PulseRain/M10_PCB/README.md

# M10_PCB
PCB Design File for PulseRain M10 board
