PulseRain/M10_PCB/V1.11/schematic.pdf

A

A

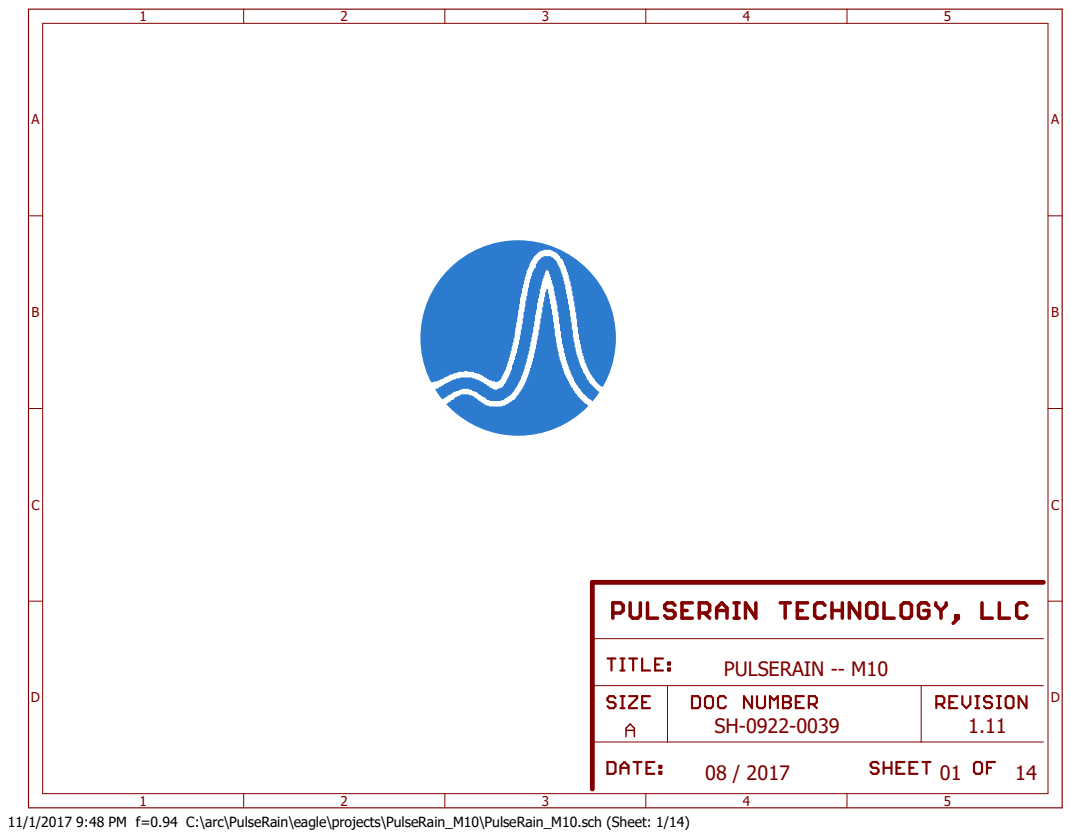
[picture p15: page 1]
PULSERAIN -- M10

11/1/2017 9:48 PM f=0.94 C:\arc\PulseRain\eagle\projects\PulseRain_M10\PulseRain_M10.sch (Sheet: 1/14)

# GND ⁺³V3 10k 10k

# C5 R⁷ R⁸

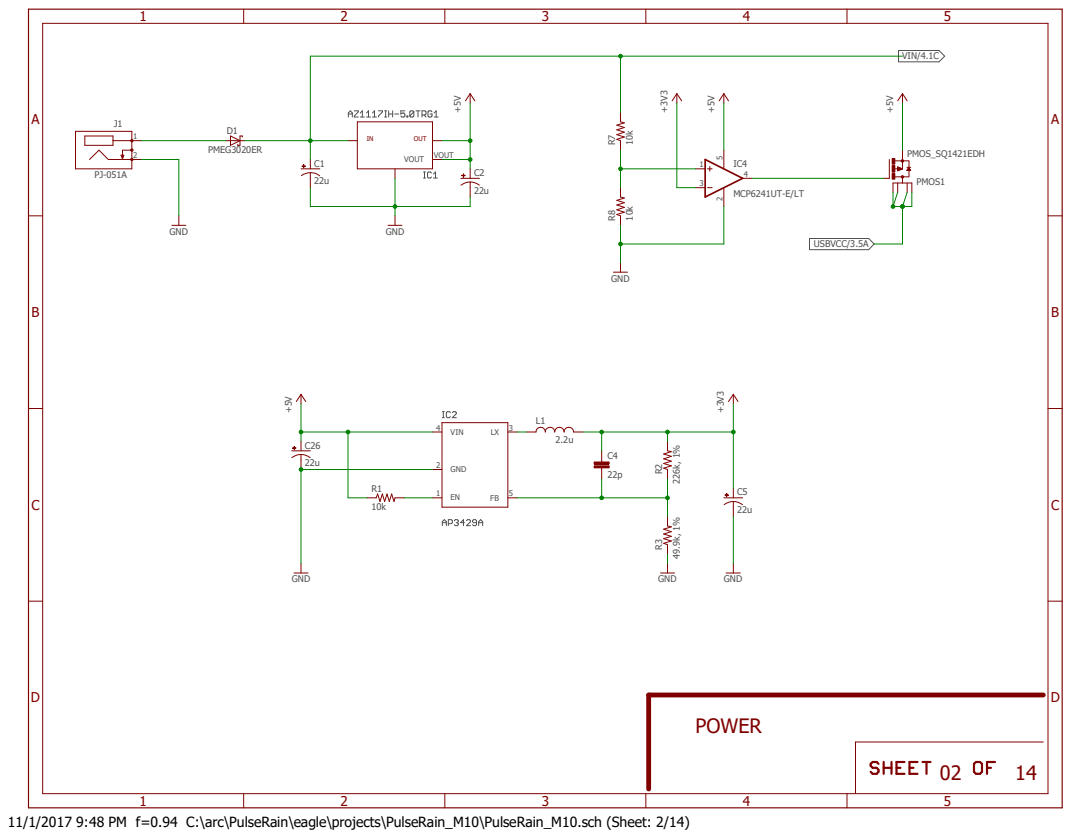
[picture p16: page 2]

11/1/2017 9:48 PM f=0.94 C:\arc\PulseRain\eagle\projects\PulseRain_M10\PulseRain_M10.sch (Sheet: 2/14)

A

A

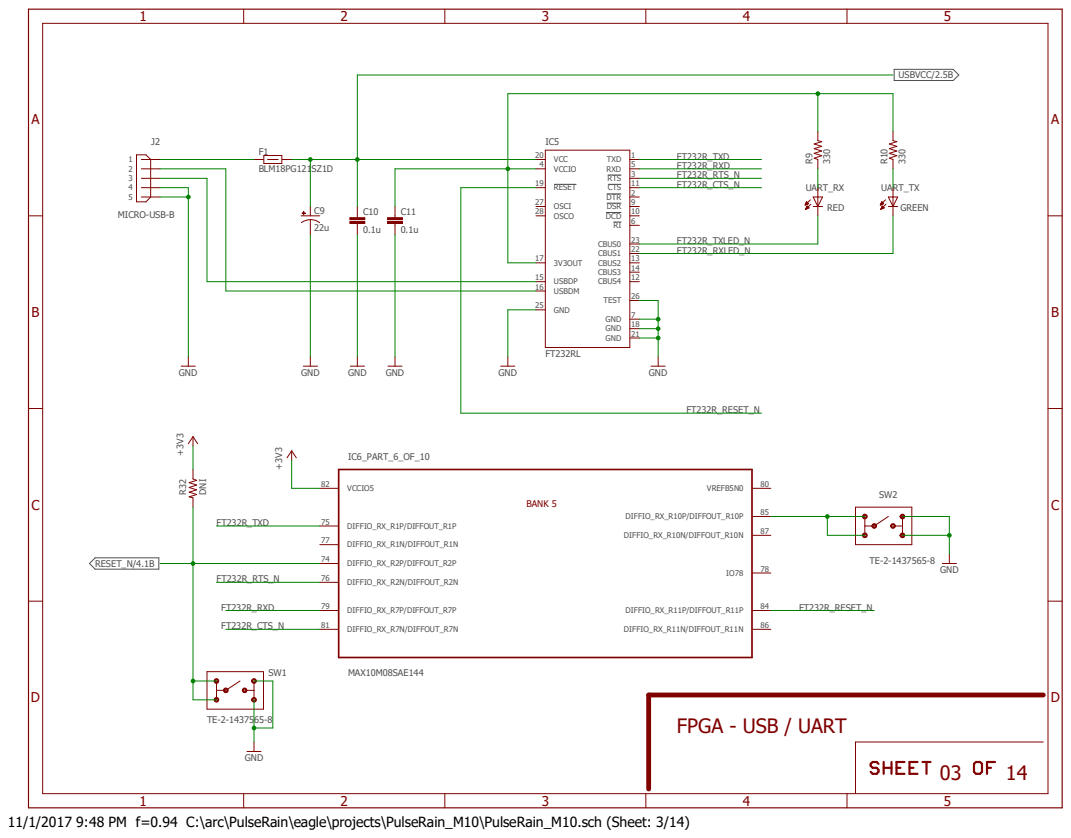
[picture p17: page 3]
MICRO-USB-B; GND; BLM18PG121SZ1D; RED; GREEN ³³⁰; MAX10M08SAE144 ⁺³V3; GND DNI +³V3; IC5VCC 20; 3V3OUT 17; USBDP 15; USBDM 16; OSCO 28; OSCI 27; TXD; 1 RXD; 5 RTS; 3 CTS; 11 DTR; 2 DSR; 9 DCD; 6 CBUS0; 23 CBUS1; 22 CBUS2; 13 CBUS3; 14 CBUS4; 12 VCCIO 4; RESET 19; GND 25; 18 TEST; 26 GND; UART_RX; UART_TX R⁹; R¹⁰; DIFFIO_RX_R1P/DIFFOUT_R1P 75; DIFFIO_RX_R1N/DIFFOUT_R1N 77; DIFFIO_RX_R2P/DIFFOUT_R2P 74; DIFFIO_RX_R2N/DIFFOUT_R2N 76; DIFFIO_RX_R10P/DIFFOUT_R10P; 85 DIFFIO_RX_R10N/DIFFOUT_R10N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

FPGA - USB / UART

11/1/2017 9:48 PM f=0.94 C:\arc\PulseRain\eagle\projects\PulseRain_M10\PulseRain_M10.sch (Sheet: 3/14)

# 9~ 9 SDA SDA

# 8 SCL SCL

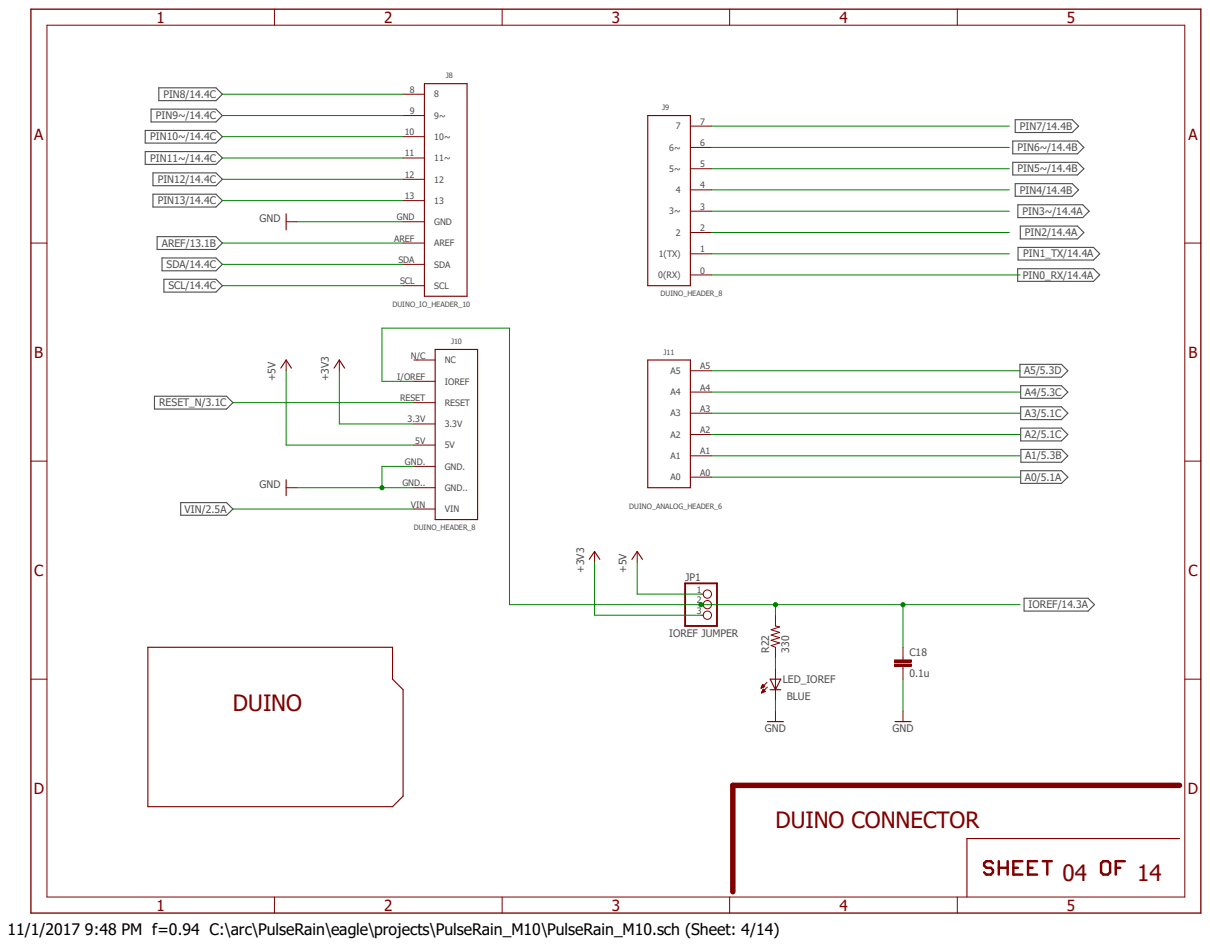
[picture p18: page 4]
IOREF JUMPER ⁺³V3; GND ³³⁰; BLUE; GND; DUINO_IO_HEADER_10; DUINO_HEADER_8 DUINO_HEADER_8 GND⁺⁵V; DUINO_ANALOG_HEADER_6; C18 R²²; LED_IOREF; AREF AREF; GND GND; IOREF I/OREF; RESET RESET; GND.. GND..; GND. GND.; VIN VIN; VIN/2.5A; IOREF/14.3A; RESET_N/3.1C; SCL/14.4C; SDA/14.4C; AREF/13.1B; PIN13/14.4C; PIN12/14.4C; PIN8/14.4C; PIN0_RX/14.4A; PIN1_TX/14.4A; PIN9~/14.4C; PIN10~/14.4C; PIN11~/14.4C; PIN7/14.4B; PIN6~/14.4B; PIN5~/14.4B; PIN4/14.4B; PIN3~/14.4A; PIN2/14.4A; DUINO CONNECTOR; DUINO

11/1/2017 9:48 PM f=0.94 C:\arc\PulseRain\eagle\projects\PulseRain_M10\PulseRain_M10.sch (Sheet: 4/14)

# 1 VSS 4

A

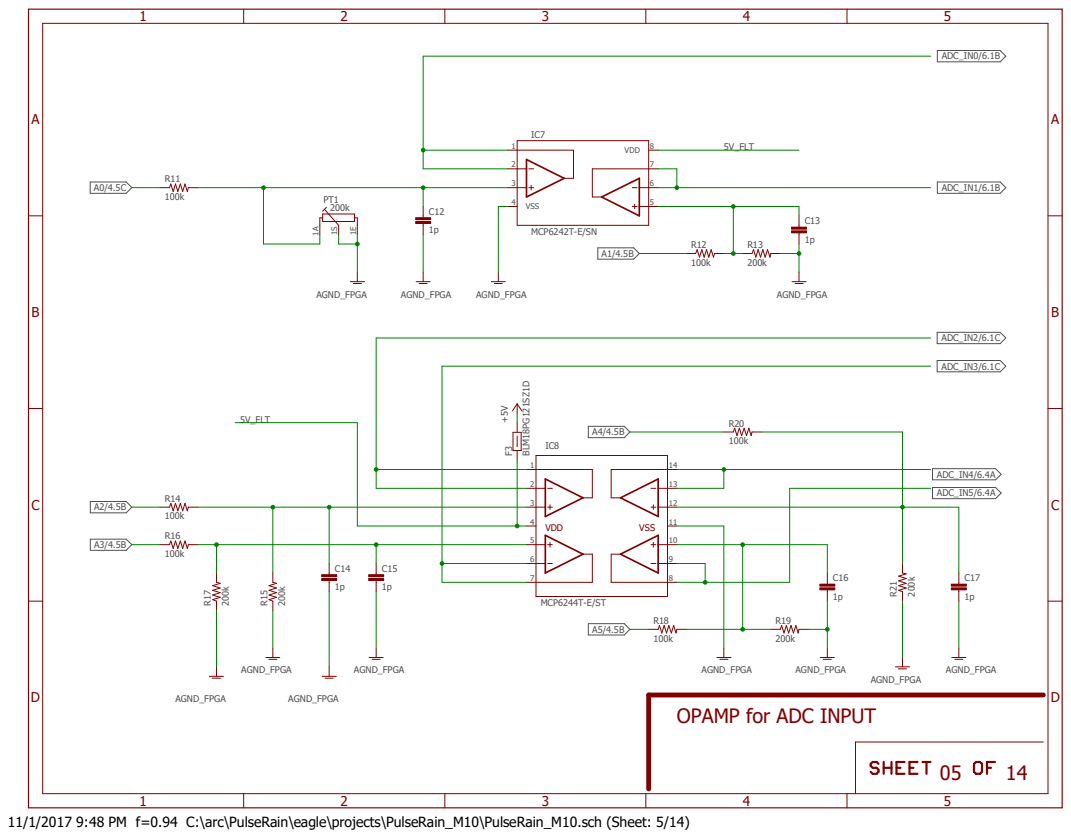
[picture p19: page 5]

OPAMP for ADC INPUT

11/1/2017 9:48 PM f=0.94 C:\arc\PulseRain\eagle\projects\PulseRain_M10\PulseRain_M10.sch (Sheet: 5/14)

A

A

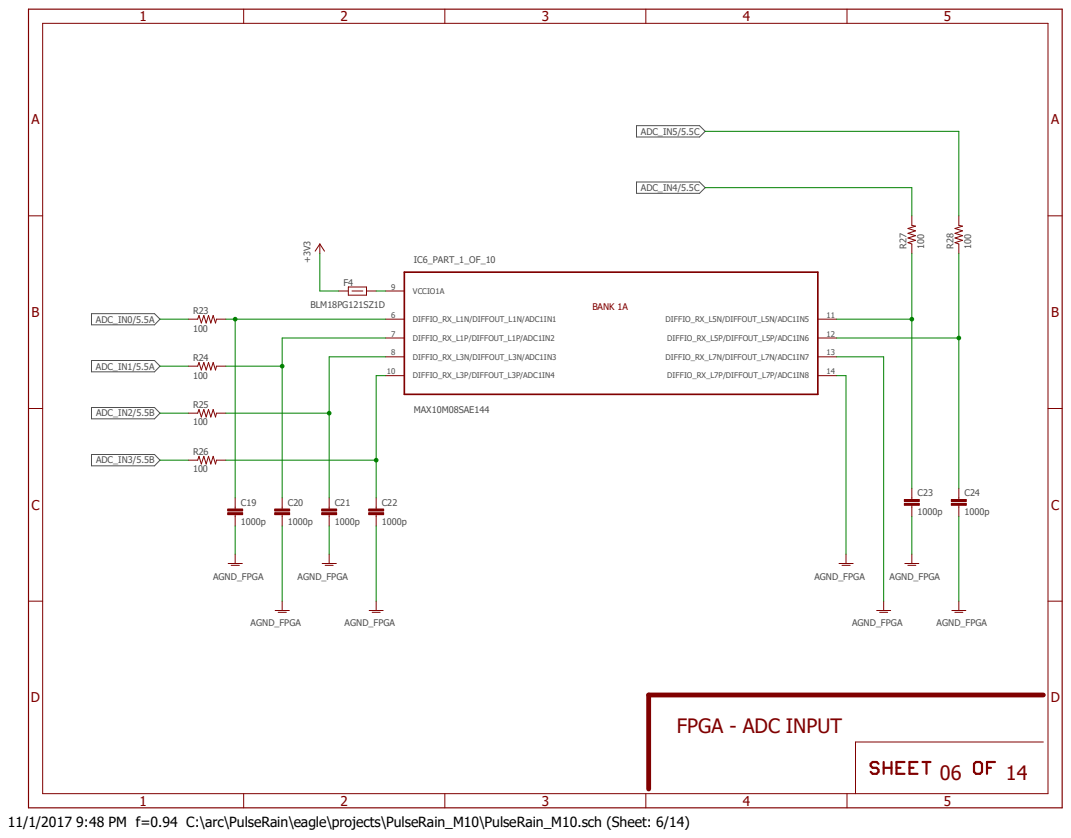
[picture p20: page 6]

11/1/2017 9:48 PM f=0.94 C:\arc\PulseRain\eagle\projects\PulseRain_M10\PulseRain_M10.sch (Sheet: 6/14)

A

A

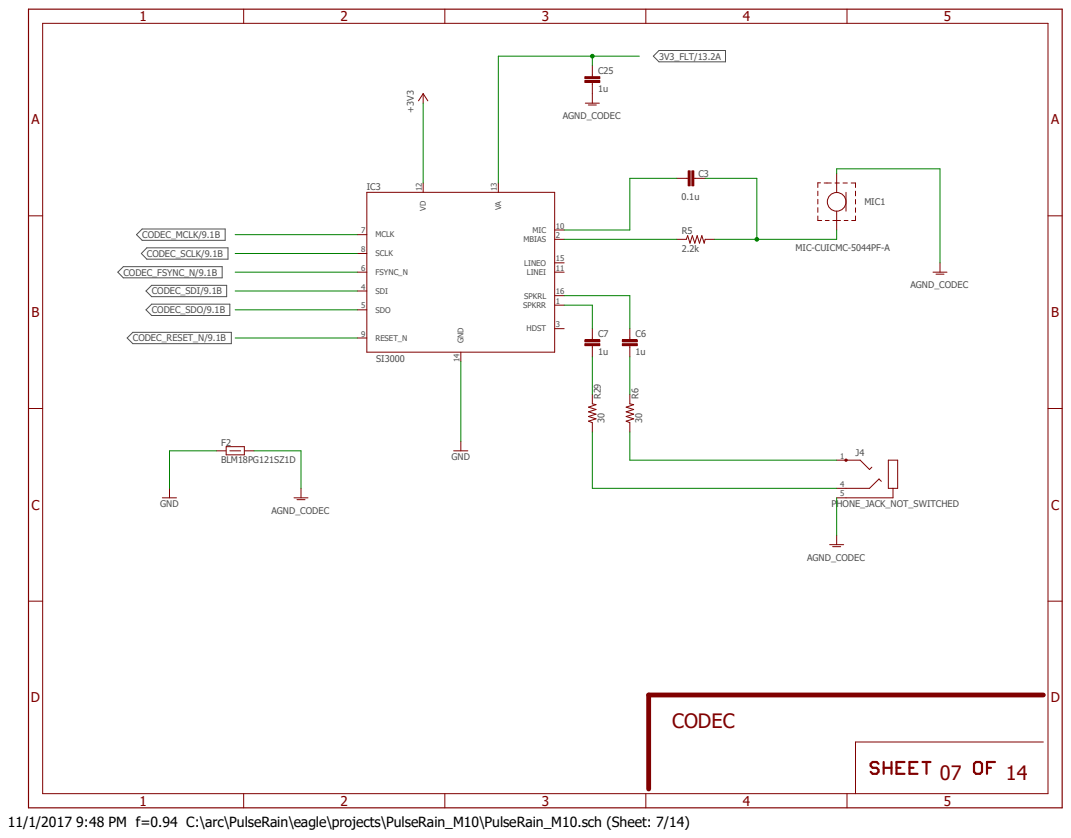
[picture p21: page 7]
PHONE_JACK_NOT_SWITCHED; GND; MIC-CUICMC-5044PF-A; AGND_CODEC; BLM18PG121SZ1D; R5 R²⁹; R⁶ MBIAS; 2 HDST; 3 SPKRR; 1 SDI 4; VA ¹³ GND 14; LINEO; 15 SPKRL; 16 SDO 5; FSYNC_N 6; MCLK 7; SCLK 8; LINEI; 11 MIC; 10 RESET_N 9; MIC1; 3V3_FLT/13.2A; CODEC_MCLK/9.1B; CODEC_SCLK/9.1B; CODEC_FSYNC_N/9.1B; CODEC_SDI/9.1B; CODEC_SDO/9.1B; CODEC_RESET_N/9.1B; CODEC

11/1/2017 9:48 PM f=0.94 C:\arc\PulseRain\eagle\projects\PulseRain_M10\PulseRain_M10.sch (Sheet: 7/14)

11/1/2017 9:48 PM f=0.94 C:\arc\PulseRain\eagle\projects\PulseRain_M10\PulseRain_M10.sch (Sheet: 8/14)

MAX10M08SAE144

# MAX10M08SAE144 ⁺³V3 +³V3

SRAM

GND | +³V3

12MHz

GND ⁺³V3

IC6_PART_7_OF_10

CLK2P/DIFFIO_RX_R14P/DIFFOUT_R14P 88 | CLK2N/DIFFIO_RX_R14N/DIFFOUT_R14N 89 | CLK3P/DIFFIO_RX_R16P/DIFFOUT_R16P 90 | CLK3N/DIFFIO_RX_R16N/DIFFOUT_R16N 91 | VCCIO6_1 94 | VREFB6N0 | 97 VCCIO6_2 103 | DIFFIO_RX_R18N/DIFFOUT_R18N 93 | DPCLK2/DIFFIO_RX_R26N/DIFFOUT_R26N 98 | DPCLK3/DIFFIO_RX_R26P/DIFFOUT_R26P 96 | DIFFIO_RX_R18P/DIFFOUT_R18P 92 | DIFFIO_RX_R27P/DIFFOUT_R27P | 99 DIFFIO_RX_R27N/DIFFOUT_R27N | 101 DIFFIO_RX_R28P/DIFFOUT_R28P | 100 DIFFIO_RX_R28N/DIFFOUT_R28N | 102 DIFFIO_RX_R33P/DIFFOUT_R33P | 105 DIFFIO_RX_R33N/DIFFOUT_R33N | 106

IC6_PART_3_OF_10

CLK0N/DIFFIO_RX_L18N/DIFFOUT_L18N 26 | CLK0P/DIFFIO_RX_L18P/DIFFOUT_L18P 27 | CLK1N/DIFFIO_RX_L20N/DIFFOUT_L20N 28 | CLK1P/DIFFIO_RX_L20P/DIFFOUT_L20P 29 | PLL_L_CLKOUTN/DIFFIO_RX_L27N/DIFFOUT_L27N | 32 PLL_L_CLKOUTP/DIFFIO_RX_L27P/DIFFOUT_L27P | 33 VCCIO2 31 | VREFB2N0 | 30

IC10

SO/SIO1 2 | NC/SIO2 3 | CS_N 1 | VSS 4 | SI/SIO0 | 5 SCK | 6 HOLD_N/SIO3 | 7 VCC | 8
IC9VCC 8 | GND | 4 OUT | 5 EN 1

3V3_PIN11~/14.2C

3V3_SDA/14.2C

3V3_SCL/14.2C

3V3_PIN8/14.2C
3V3_PIN9~/14.2C
3V3_PIN10~/14.2C

3V3_PIN12/14.2C

3V3_PIN13/14.2C

SRAM_SIO2

SRAM_SIO2

SRAM_SIO1

SRAM_SIO1

SRAM_SIO3

SRAM_SIO3

SRAM_SCK

SRAM_SCK

SRAM_SIO0

SRAM_SIO0

SRAM_CS_N

SRAM_CS_N

# FPGA - CLK / SRAM / IO

08 14

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
BANK 6

BANK 2

11/1/2017 9:48 PM f=0.94 C:\arc\PulseRain\eagle\projects\PulseRain_M10\PulseRain_M10.sch (Sheet: 9/14)

# MAX10M08SAE144 ⁺³V3

IC6_PART_4_OF_10

DIFFIO_TX_RX_B1N/DIFFOUT_B1N 38 | DIFFIO_TX_RX_B1P/DIFFOUT_B1P 39 | DIFFIO_TX_RX_B3N/DIFFOUT_B3N 41 | DIFFIO_TX_RX_B3P/DIFFOUT_B3P 43 | DIFFIO_TX_RX_B9N/DIFFOUT_B9N | 50 DIFFIO_TX_RX_B9P/DIFFOUT_B9P | 52 VCCIO3_1 40 | VREFB3N0 | 48 VCCIO3_2 49 | DIFFIO_TX_RX_B5P/DIFFOUT_B5P 45 | DIFFIO_TX_RX_B7P/DIFFOUT_B7P 47 | DIFFIO_TX_RX_B7N/DIFFOUT_B7N 46 | DIFFIO_TX_RX_B5N/DIFFOUT_B5N 44
IO54 | 54 DIFFIO_TX_RX_B12N/DIFFOUT_B12N | 55 DIFFIO_TX_RX_B12P/DIFFOUT_B12P | 56 DIFFIO_TX_RX_B14N/DIFFOUT_B14N | 57 DIFFIO_TX_RX_B14P/DIFFOUT_B14P | 58 DIFFIO_TX_RX_B16N/DIFFOUT_B16N | 59 DIFFIO_TX_RX_B16P/DIFFOUT_B16P | 60

3V3_PIN7/14.2B

3V3_PIN6~/14.2B

3V3_PIN5~/14.2B

3V3_PIN4/14.2B

3V3_PIN3~/14.2A

3V3_PIN2/14.2A

3V3_PIN1_TX/14.2A

3V3_PIN0_RX/14.2A

CODEC_SDI/7.1B

CODEC_SDO/7.1B

CODEC_FSYNC_N/7.1B

CODEC_MCLK/7.1B

CODEC_SCLK/7.1B
CODEC_RESET_N/7.1B

JTAG_PIN6/10.5C

JTAG_PIN8/10.5C

JTAG_PIN7/10.5C

09 14

# FPGA - PUSH BUTTON / IO

BANK 3

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
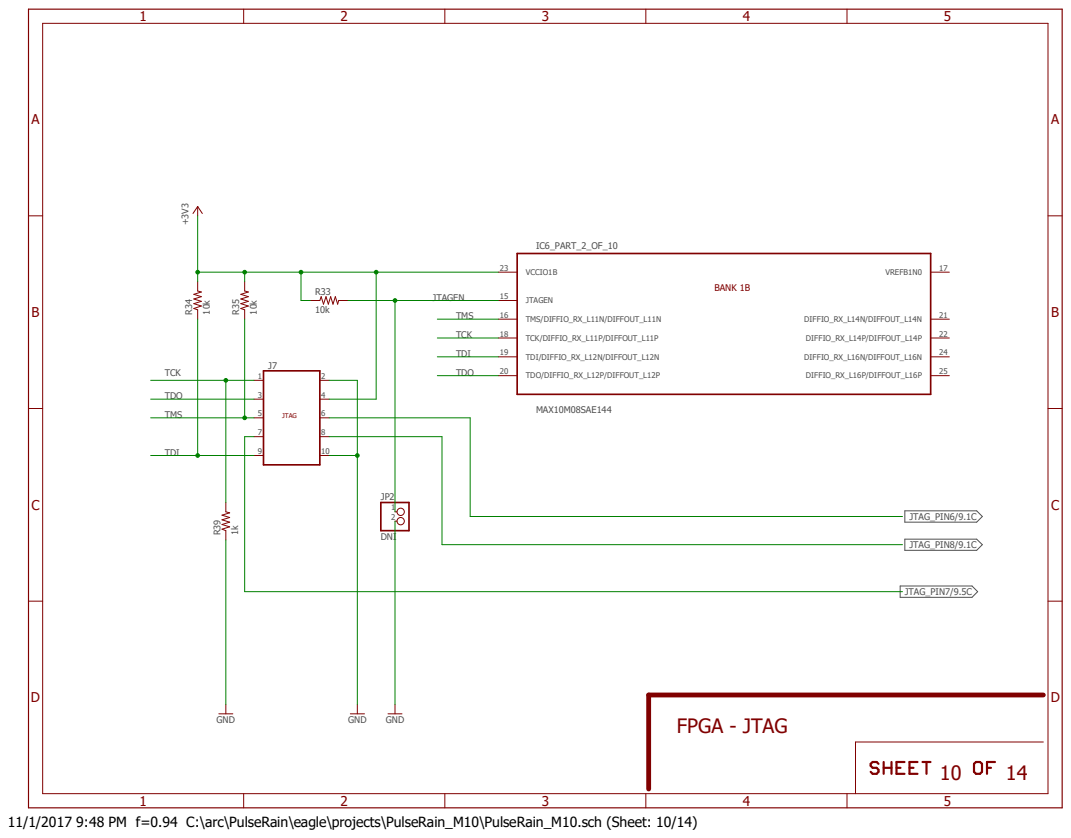
[picture p22: page 10]
MAX10M08SAE144 ⁺³V3; GND ¹⁰k; GND ¹k; DNI; GND; IC6_PART_2_OF_10; JTAGEN 15; TMS/DIFFIO_RX_L11N/DIFFOUT_L11N 16; TCK/DIFFIO_RX_L11P/DIFFOUT_L11P 18; TDI/DIFFIO_RX_L12N/DIFFOUT_L12N 19; TDO/DIFFIO_RX_L12P/DIFFOUT_L12P 20; DIFFIO_RX_L14N/DIFFOUT_L14N; 21 DIFFIO_RX_L14P/DIFFOUT_L14P; 22 DIFFIO_RX_L16N/DIFFOUT_L16N; 24 VCCIO1B 23; VREFB1N0; 17 DIFFIO_RX_L16P/DIFFOUT_L16P; R33 R³⁴; R³⁵ R³⁹; JTAGEN; TMS; TCK; TDI; TDO; JTAG_PIN6/9.1C; JTAG_PIN8/9.1C; JTAG_PIN7/9.5C; FPGA - JTAG; BANK 1B; JTAG

11/1/2017 9:48 PM f=0.94 C:\arc\PulseRain\eagle\projects\PulseRain_M10\PulseRain_M10.sch (Sheet: 10/14)

11/1/2017 9:48 PM f=0.94 C:\arc\PulseRain\eagle\projects\PulseRain_M10\PulseRain_M10.sch (Sheet: 11/14)

MAX10M08SAE144

# MAX10M08SAE144 ⁺³V3

GND ⁺³V3 +³V3

0472192001

IC6_PART_5_OF_10

IO62 62 | DIFFIO_TX_RX_B23N/DIFFOUT_B23N 64 | DIFFIO_TX_RX_B23P/DIFFOUT_B23P 65 | VCCIO4 67 | VREFB4N0 | 61
IO66 | 66 DIFFIO_TX_RX_B27N/DIFFOUT_B27N | 69 DIFFIO_TX_RX_B27P/DIFFOUT_B27P | 70

IC6_PART_8_OF_10

IO113 113 | DIFFIO_RX_T1P/DIFFOUT_T1P 110 | DIFFIO_RX_T1N/DIFFOUT_T1N 111 | VCCIO7 117 | VREFB7N0 | 112
IO114 | 114 DIFFIO_RX_T10P/DIFFOUT_T10P | 118 DIFFIO_RX_T10N/DIFFOUT_T10N | 119
IC11 DAT2 1 | CD/DAT3 2 | CMD 3 | VDD 4 | CLK | 5 VSS | 6 DAT0 | 7 DAT1 MICRO_SD_DAT2 | 8 MICRO_SD_DAT2

MICRO_SD_CD_DAT3

MICRO_SD_CD_DAT3

MICRO_SD_CMD

MICRO_SD_CMD

MICRO_SD_DAT1

MICRO_SD_DAT1

MICRO_SD_DAT0

MICRO_SD_DAT0

MICRO_SD_CLK

MICRO_SD_CLK

11 14

# FPGA - MICRO SD

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
BANK 4

BANK 7

A

A

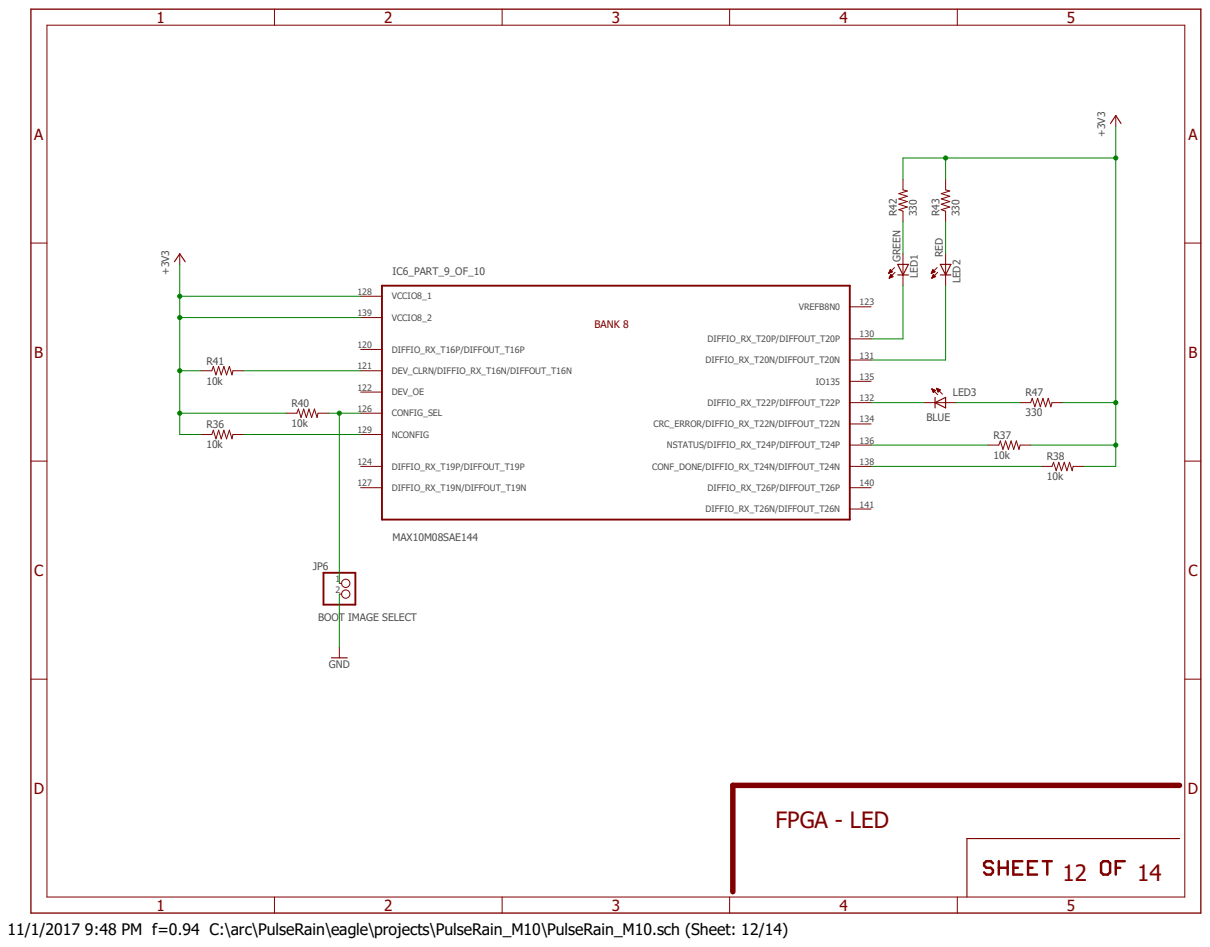
[picture p23: page 12]

11/1/2017 9:48 PM f=0.94 C:\arc\PulseRain\eagle\projects\PulseRain_M10\PulseRain_M10.sch (Sheet: 12/14)

# GND ⁺³V3

A

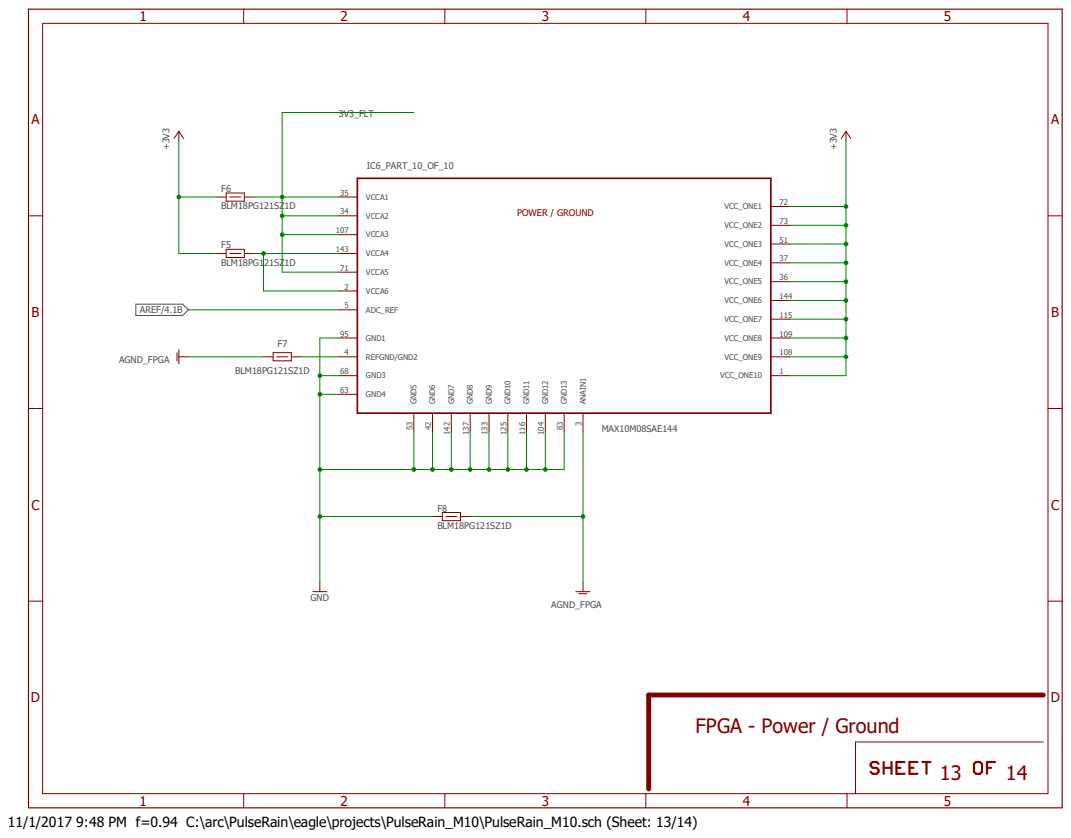
[picture p24: page 13]
MAX10M08SAE144; BLM18PG121SZ1D; AGND_FPGA; IC6_PART_10_OF_10 VCCA1 35; VCCA2 34; VCCA3 107; VCCA4 143; VCCA5 71; VCCA6 2; ADC_REF 5; VCC_ONE1; 72 VCC_ONE2; 73 VCC_ONE3; 51 VCC_ONE4; 37 VCC_ONE5; 36 VCC_ONE6; 144 VCC_ONE7; 115 VCC_ONE8; 109 VCC_ONE9; 108 VCC_ONE10; 1 GND1 95; REFGND/GND2 4; GND3 68; GND4 63; GND⁵ 53; GND⁶ 42; GND⁷ 142; GND⁸ 137; GND⁹ 133; GND¹⁰ 125; GND¹¹ 116; GND¹² 104; GND¹³ 83; ANAIN¹; AREF/4.1B; 3V3_FLT; POWER / GROUND

FPGA - Power / Ground

11/1/2017 9:48 PM f=0.94 C:\arc\PulseRain\eagle\projects\PulseRain_M10\PulseRain_M10.sch (Sheet: 13/14)

# TXS0108EPWR ⁺³V3

A

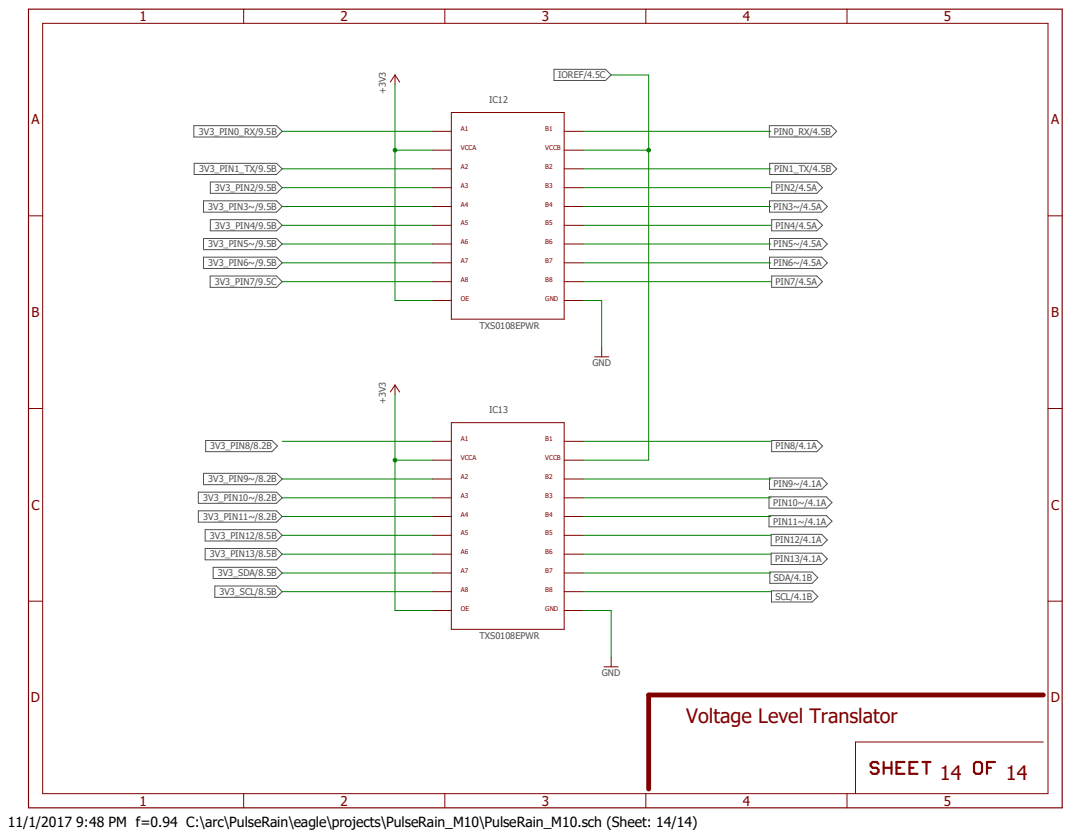
[picture p25: page 14]
TXS0108EPWR; GND; GND ⁺³V3; 3V3_PIN0_RX/9.5B; 3V3_PIN1_TX/9.5B; 3V3_PIN2/9.5B; 3V3_PIN3~/9.5B; 3V3_PIN4/9.5B; 3V3_PIN5~/9.5B; 3V3_PIN6~/9.5B; 3V3_PIN7/9.5C; PIN0_RX/4.5B; PIN1_TX/4.5B; PIN2/4.5A; PIN3~/4.5A; PIN4/4.5A; PIN5~/4.5A; PIN6~/4.5A; PIN7/4.5A; IOREF/4.5C; PIN8/4.1A; PIN9~/4.1A; PIN10~/4.1A; PIN11~/4.1A; PIN12/4.1A; PIN13/4.1A; SDA/4.1B; SCL/4.1B; 3V3_PIN9~/8.2B; 3V3_PIN10~/8.2B; 3V3_PIN12/8.5B; 3V3_PIN13/8.5B; 3V3_PIN8/8.2B; 3V3_PIN11~/8.2B; 3V3_SDA/8.5B; 3V3_SCL/8.5B; 5 A1VCCA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

Voltage Level Translator

11/1/2017 9:48 PM f=0.94 C:\arc\PulseRain\eagle\projects\PulseRain_M10\PulseRain_M10.sch (Sheet: 14/14)
