PulseRain/M10_PCB/V1.11/PulseRain_M10.brd

## EAGLE design V1.11/PulseRain_M10.brd (2017-11-02)

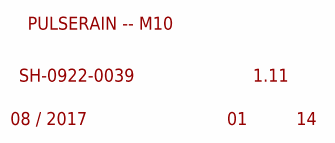
[picture p37: schematic PulseRain_M10.sch, sheet 1]

Parts:
GND: PULSERAIN_LOGO_BIGGER

Notes on the sheet:
1.11
SH-0922-0039
PULSERAIN -- M10
08 / 2017

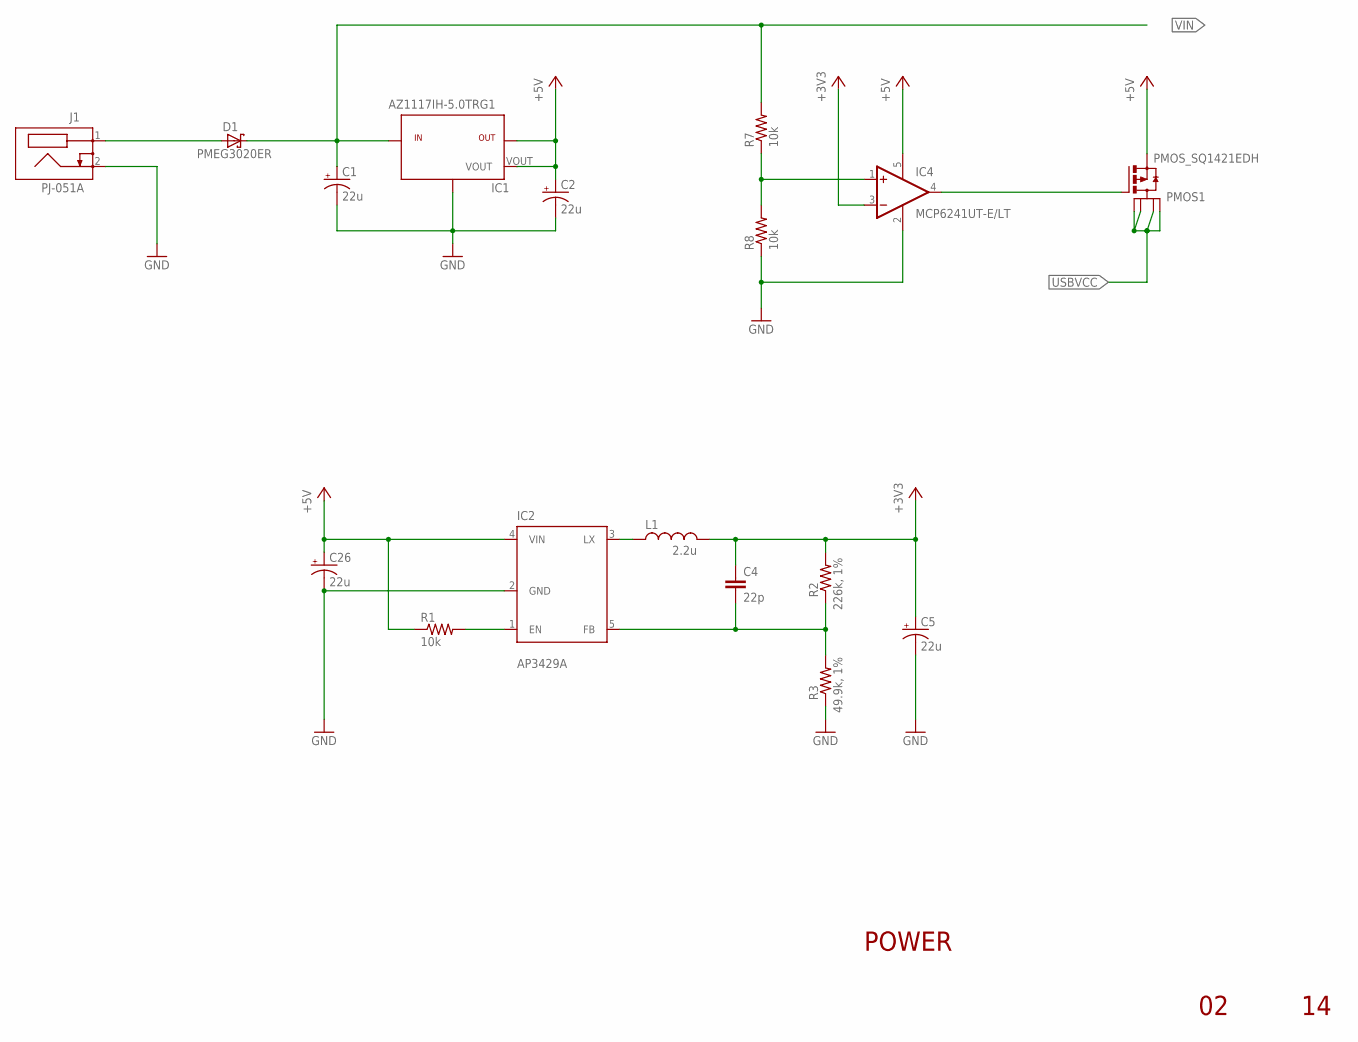
[picture p38: schematic PulseRain_M10.sch, sheet 2]

Parts:
C1, C2, C5, C26: 22u; PANASONIC_B
C4: 22p; 0603-CAP
D1: PMEG3020ER; SOD123W
IC1: AZ1117IH-5.0TRG1; SOT223
IC2: AP3429A; TSOT25
IC4: MCP6241UT-E/LT; SC-70-5
J1: PJ-051A
L1: 2.2u; DFE252012C
PMOS1: PMOS_SQ1421EDH; SC70-6L
R1, R7, R8: 10k; VISHAY-R-0603
R2: 226k, 1%; VISHAY-R-0603
R3: 49.9k, 1%; VISHAY-R-0603

Connections:
+3V3: C4.1, C5.+, IC4.3 (-IN), L1.2, R2.P$2 (2); also elsewhere on the board
+5V: C2.+, C26.+, IC1.2, IC1.VOUT, IC2.4 (VIN), IC4.5 (V+), PMOS1.4 (S), R1.P$1 (1); also elsewhere on the board
GND: C1.-, C2.-, C5.-, C26.-, IC1.1, IC2.2 (GND), IC4.2 (V-), J1.2, R3.P$1 (1), R8.P$1 (1); also elsewhere on the board
unnamed: D1.2, J1.1
unnamed: IC4.1 (+IN), R7.P$1 (1), R8.P$2 (2)
unnamed: IC2.3 (LX), L1.1
unnamed: IC2.1 (EN), R1.P$2 (2)
unnamed: C4.2, IC2.5 (FB), R2.P$1 (1), R3.P$2 (2)
unnamed: IC4.4 (OUT), PMOS1.3 (G)
USBVCC: PMOS1.1 (D1), PMOS1.2 (D2), PMOS1.5 (D3), PMOS1.6 (D4); also elsewhere on the board
VIN: C1.+, D1.1, IC1.3, R7.P$2 (2); also elsewhere on the board

Notes on the sheet:
POWER

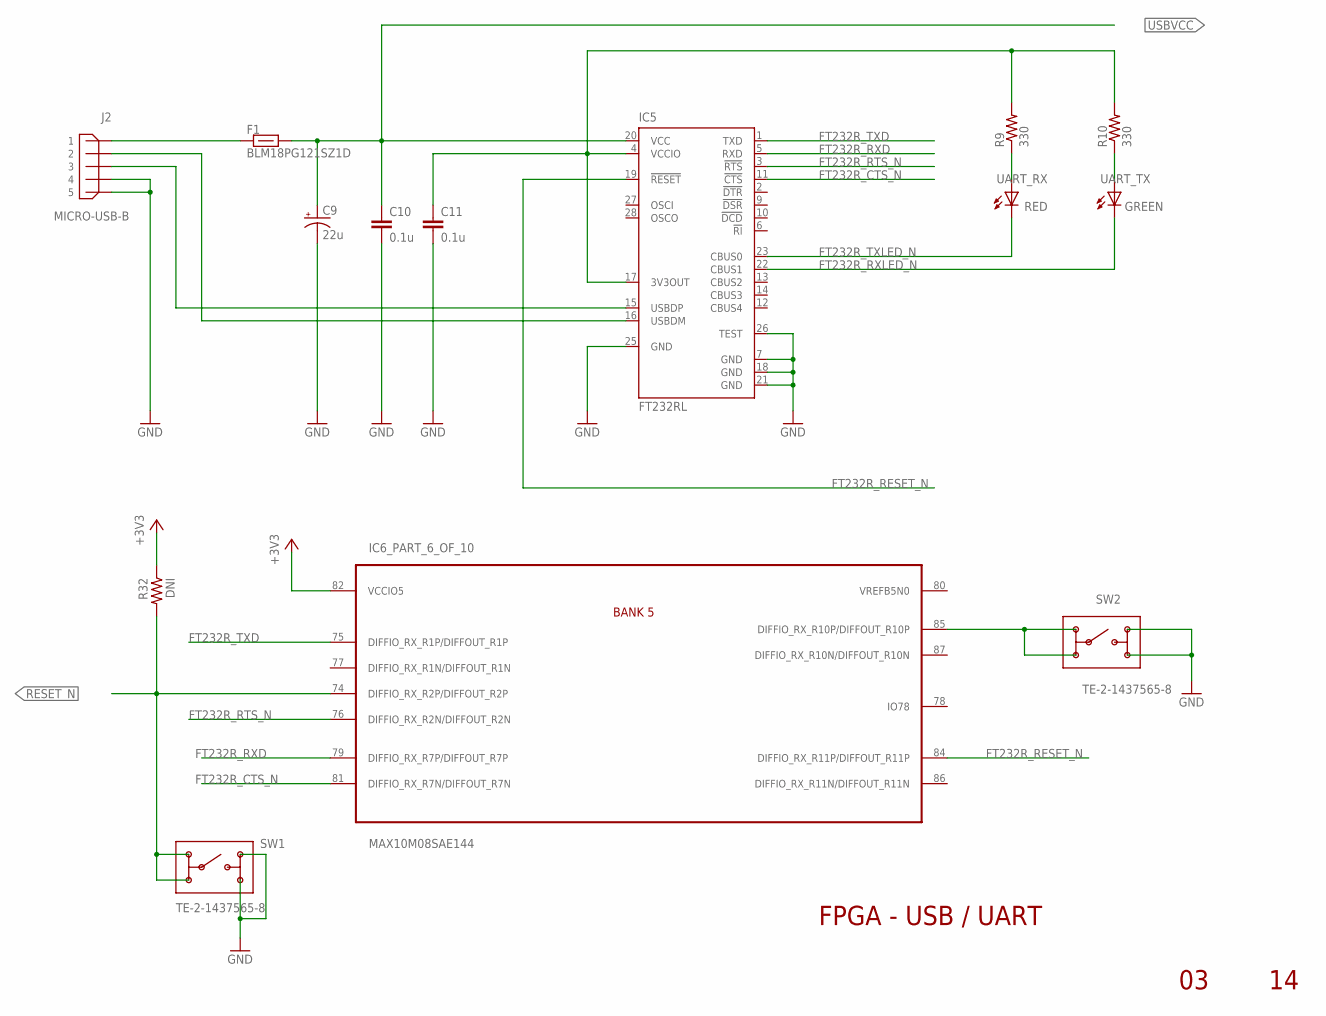
[picture p39: schematic PulseRain_M10.sch, sheet 3]

Parts:
C9: 22u; PANASONIC_B
C10, C11: 0.1u; 0603-CAP
F1: BLM18PG121SZ1D; 0603-BEAD
IC5: FT232RL; SSOP28
IC6: MAX10M08SAE144; EQFP144
J2: MICRO-USB-B; SD-47346-001
R9, R10: 330; VISHAY-R-0603
R32: DNI; VISHAY-R-0603
SW1, SW2: TE-2-1437565-8
UART_RX: RED; HARVATEK_0603
UART_TX: GREEN; HARVATEK_0603

Connections:
+3V3: IC6.82 (VCCIO5), R32.P$1 (1); also elsewhere on the board
FT232R_CTS_N: IC5.11 (!CTS), IC6.81 (DIFFIO_RX_R7N/DIFFOUT_R7N)
FT232R_RESET_N: IC5.19 (!RESET), IC6.84 (DIFFIO_RX_R11P/DIFFOUT_R11P)
FT232R_RTS_N: IC5.3 (!RTS), IC6.76 (DIFFIO_RX_R2N/DIFFOUT_R2N)
FT232R_RXD: IC5.5 (RXD), IC6.79 (DIFFIO_RX_R7P/DIFFOUT_R7P)
FT232R_RXLED_N: IC5.22 (CBUS1), UART_TX.C
FT232R_TXD: IC5.1 (TXD), IC6.75 (DIFFIO_RX_R1P/DIFFOUT_R1P)
FT232R_TXLED_N: IC5.23 (CBUS0), UART_RX.C
GND: C9.-, C10.2, C11.2, IC5.7 (GND), IC5.18 (GND), IC5.21 (GND), IC5.25 (GND), IC5.26 (TEST), J2.4, J2.5, SW1.3, SW1.4, SW2.3, SW2.4; also elsewhere on the board
unnamed: F1.1, J2.1
unnamed: IC6.85 (DIFFIO_RX_R10P/DIFFOUT_R10P), SW2.1, SW2.2
unnamed: C11.1, IC5.4 (VCCIO), IC5.17 (3V3OUT), R9.P$2 (2), R10.P$2 (2)
unnamed: R9.P$1 (1), UART_RX.A
unnamed: R10.P$1 (1), UART_TX.A
RESET_N: IC6.74 (DIFFIO_RX_R2P/DIFFOUT_R2P), R32.P$2 (2), SW1.1, SW1.2; also elsewhere on the board
USBVCC: C9.+, C10.1, F1.2, IC5.20 (VCC); also elsewhere on the board
USB_DATA_N: IC5.16 (USBDM), J2.2
USB_DATA_P: IC5.15 (USBDP), J2.3

Notes on the sheet:
FPGA - USB / UART

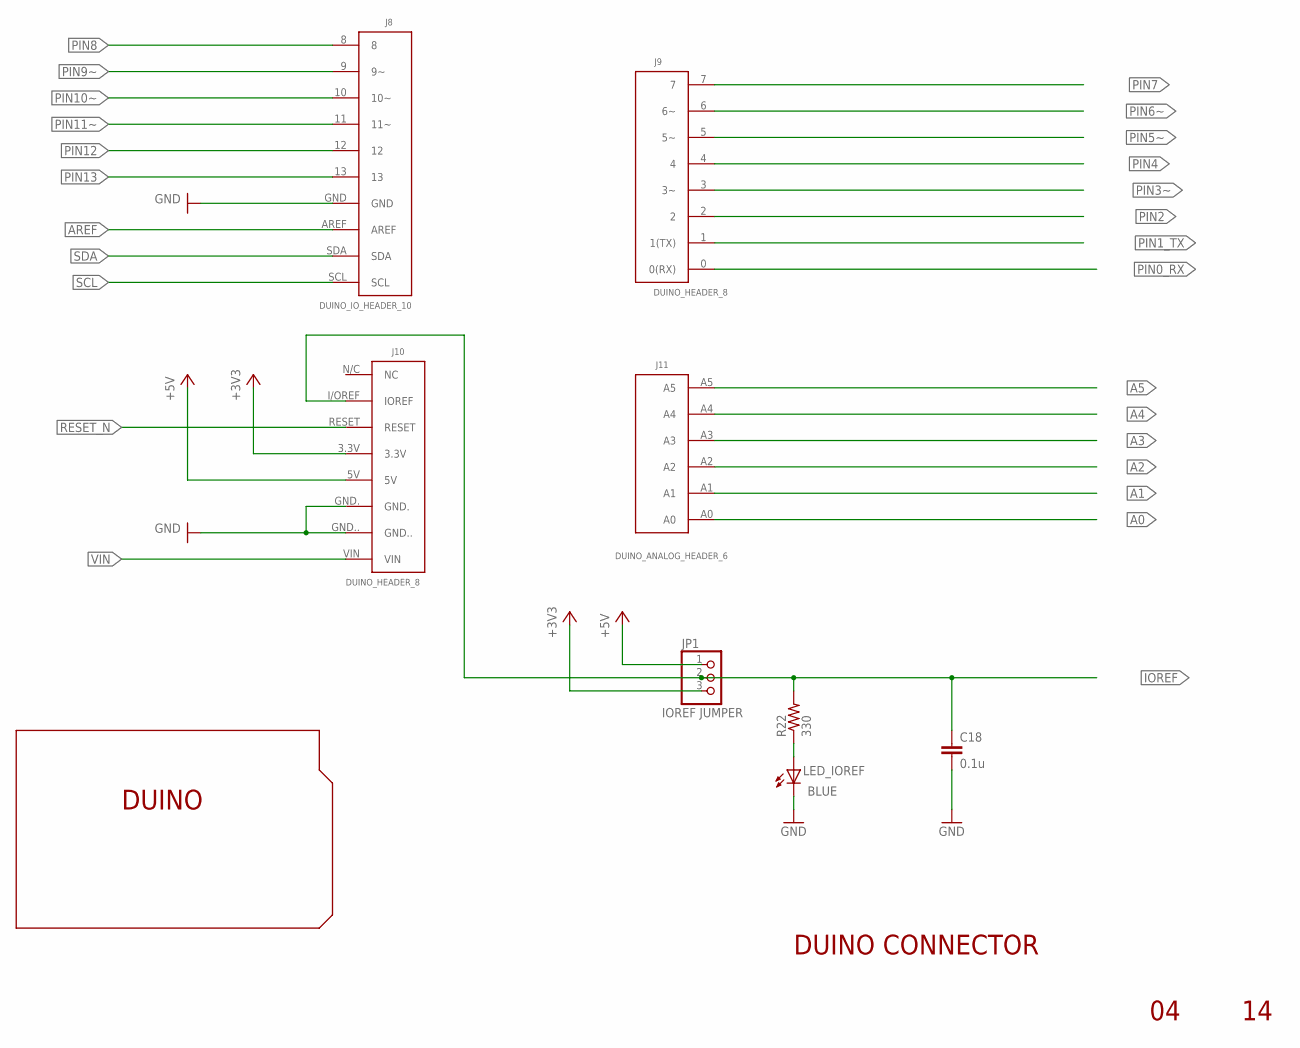
[picture p40: schematic PulseRain_M10.sch, sheet 4]

Parts:
C18: 0.1u; 0603-CAP
J8: DUINO_IO_HEADER_10
J9: DUINO_HEADER_8; DUINO_IO_HEADER_8
J10: DUINO_HEADER_8; DUINO_PWR_HEADER_8
J11: DUINO_ANALOG_HEADER_6
JP1: IOREF JUMPER; 1X03
LED_IOREF: BLUE; HARVATEK_0603
R22: 330; VISHAY-R-0603
U$8: DUINO

Connections:
+3V3: J10.3.3V, JP1.3; also elsewhere on the board
+5V: J10.5V, JP1.1; also elsewhere on the board
A0: J11.A0; also elsewhere on the board
A1: J11.A1; also elsewhere on the board
A2: J11.A2; also elsewhere on the board
A3: J11.A3; also elsewhere on the board
A4: J11.A4; also elsewhere on the board
A5: J11.A5; also elsewhere on the board
AREF: J8.AREF; also elsewhere on the board
GND: C18.2, J8.GND, J10.GND., J10.GND.., LED_IOREF.C; also elsewhere on the board
IOREF: C18.1, J10.I/OREF (IOREF), JP1.2, R22.P$2 (2); also elsewhere on the board
unnamed: LED_IOREF.A, R22.P$1 (1)
PIN0_RX: J9.0 (0(RX)); also elsewhere on the board
PIN1_TX: J9.1 (1(TX)); also elsewhere on the board
PIN2: J9.2; also elsewhere on the board
PIN3~: J9.3 (3~); also elsewhere on the board
PIN4: J9.4; also elsewhere on the board
PIN5~: J9.5 (5~); also elsewhere on the board
PIN6~: J9.6 (6~); also elsewhere on the board
PIN7: J9.7; also elsewhere on the board
PIN8: J8.8; also elsewhere on the board
PIN9~: J8.9 (9~); also elsewhere on the board
PIN10~: J8.10 (10~); also elsewhere on the board
PIN11~: J8.11 (11~); also elsewhere on the board
PIN12: J8.12; also elsewhere on the board
PIN13: J8.13; also elsewhere on the board
RESET_N: J10.RESET; also elsewhere on the board
SCL: J8.SCL; also elsewhere on the board
SDA: J8.SDA; also elsewhere on the board
VIN: J10.VIN; also elsewhere on the board

Notes on the sheet:
DUINO CONNECTOR

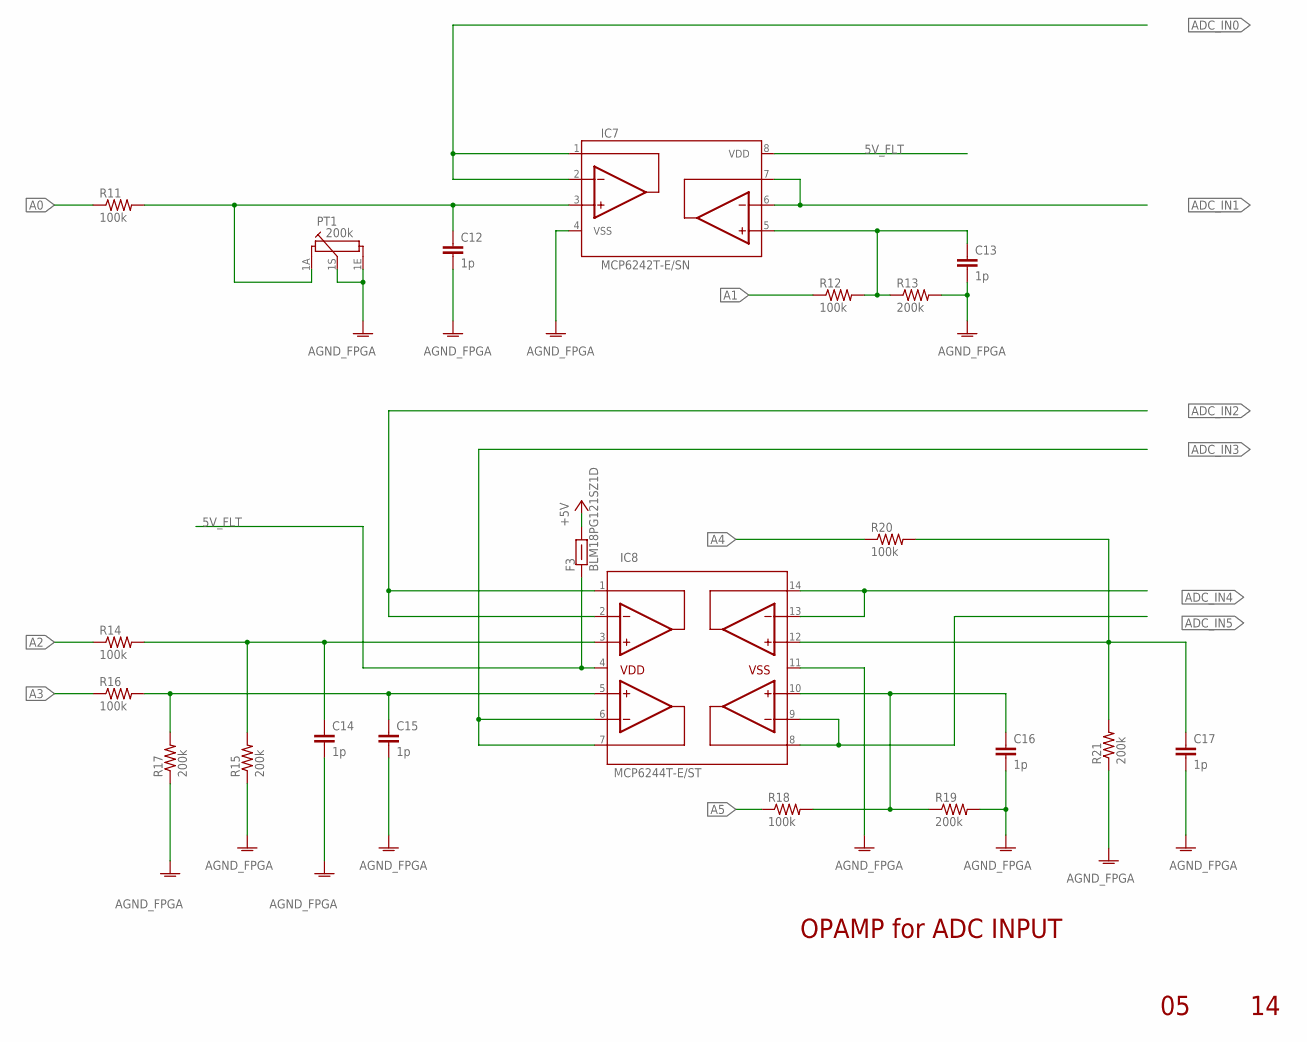
[picture p41: schematic PulseRain_M10.sch, sheet 5]

Parts:
C12, C13, C14, C15, C16, C17: 1p; 0603-CAP
F3: BLM18PG121SZ1D; 0603-BEAD
IC7: MCP6242T-E/SN; SOIC-SN-8
IC8: MCP6244T-E/ST; TSSOP-ST-14
PT1: 200k; PT10LV10
R11, R12, R14, R16, R18, R20: 100k; VISHAY-R-0603
R13, R15, R17, R19, R21: 200k; VISHAY-R-0603

Connections:
5V_FLT: F3.1, IC7.8 (VDD), IC8.4
+5V: F3.2; also elsewhere on the board
A0: R11.P$1 (1); also elsewhere on the board
A1: R12.P$1 (1); also elsewhere on the board
A2: R14.P$1 (1); also elsewhere on the board
A3: R16.P$1 (1); also elsewhere on the board
A4: R20.P$1 (1); also elsewhere on the board
A5: R18.P$1 (1); also elsewhere on the board
ADC_IN0: IC7.1, IC7.2; also elsewhere on the board
ADC_IN1: IC7.6, IC7.7; also elsewhere on the board
ADC_IN2: IC8.1, IC8.2; also elsewhere on the board
ADC_IN3: IC8.6, IC8.7; also elsewhere on the board
ADC_IN4: IC8.13, IC8.14; also elsewhere on the board
ADC_IN5: IC8.8, IC8.9; also elsewhere on the board
AGND_FPGA: C12.2, C13.2, C14.2, C15.2, C16.2, C17.2, IC7.4 (VSS), IC8.11, PT1.1E, PT1.1S, R13.P$2 (2), R15.P$1 (1), R17.P$1 (1), R19.P$2 (2), R21.P$1 (1); also elsewhere on the board
unnamed: C13.1, IC7.5, R12.P$2 (2), R13.P$1 (1)
unnamed: C16.1, IC8.10, R18.P$2 (2), R19.P$1 (1)
unnamed: C14.1, IC8.3, R14.P$2 (2), R15.P$2 (2)
unnamed: C15.1, IC8.5, R16.P$2 (2), R17.P$2 (2)
unnamed: C12.1, IC7.3, PT1.1A, R11.P$2 (2)
unnamed: C17.1, IC8.12, R20.P$2 (2), R21.P$2 (2)

Notes on the sheet:
OPAMP for ADC INPUT

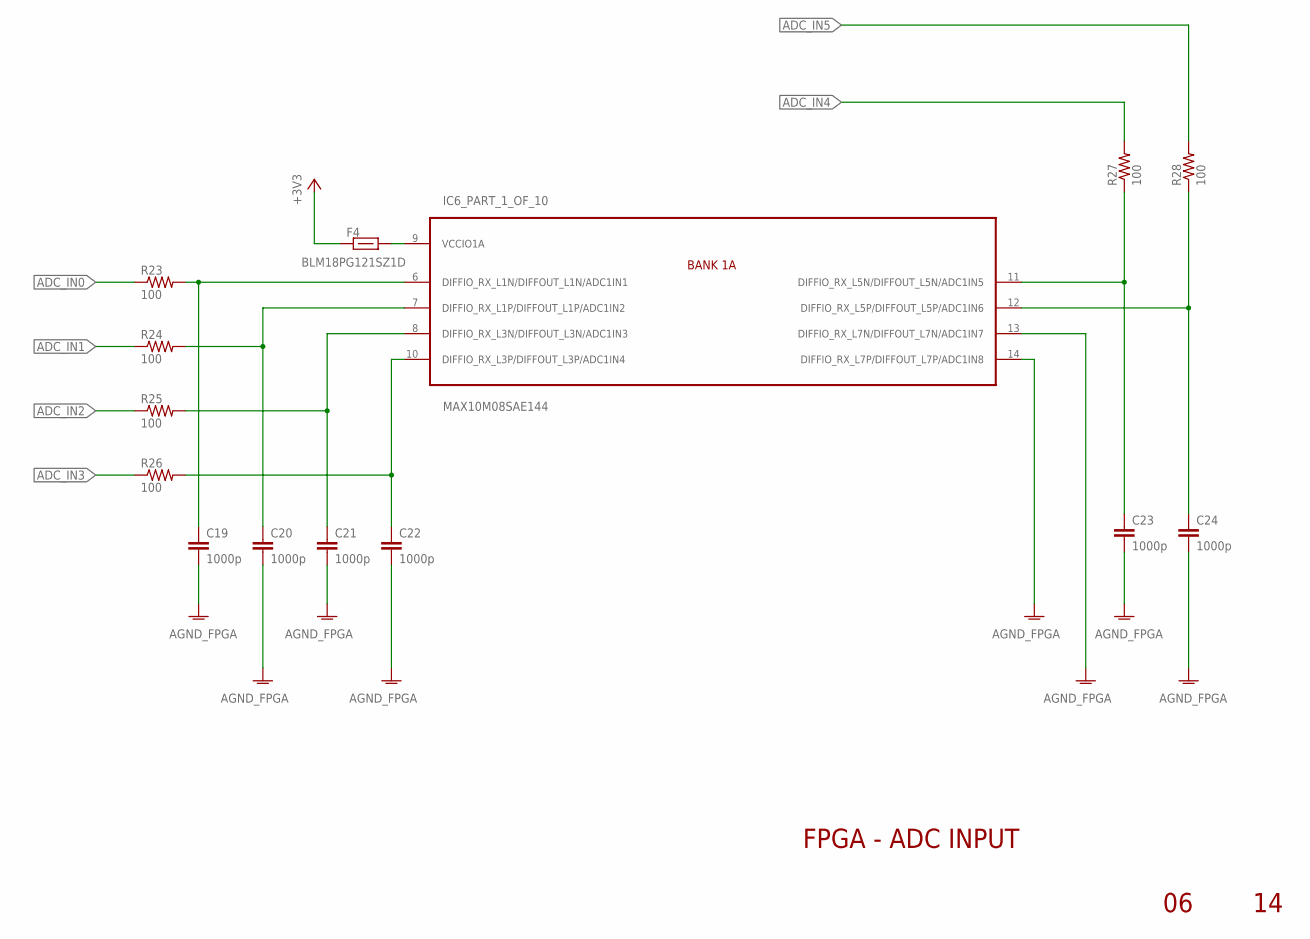
[picture p42: schematic PulseRain_M10.sch, sheet 6]

Parts:
C19, C20, C21, C22, C23, C24: 1000p; VISHAY-R-0603
F4: BLM18PG121SZ1D; 0603-BEAD
IC6: MAX10M08SAE144; EQFP144
R23, R24, R25, R26, R27, R28: 100; VISHAY-R-0603

Connections:
+3V3: F4.1; also elsewhere on the board
ADC_IN0: R23.P$1 (1); also elsewhere on the board
ADC_IN1: R24.P$1 (1); also elsewhere on the board
ADC_IN2: R25.P$1 (1); also elsewhere on the board
ADC_IN3: R26.P$1 (1); also elsewhere on the board
ADC_IN4: R27.P$2 (2); also elsewhere on the board
ADC_IN5: R28.P$2 (2); also elsewhere on the board
AGND_FPGA: C19.P$2 (2), C20.P$2 (2), C21.P$2 (2), C22.P$2 (2), C23.P$2 (2), C24.P$2 (2), IC6.13 (DIFFIO_RX_L7N/DIFFOUT_L7N/ADC1IN7), IC6.14 (DIFFIO_RX_L7P/DIFFOUT_L7P/ADC1IN8); also elsewhere on the board
unnamed: C23.P$1 (1), IC6.11 (DIFFIO_RX_L5N/DIFFOUT_L5N/ADC1IN5), R27.P$1 (1)
unnamed: C19.P$1 (1), IC6.6 (DIFFIO_RX_L1N/DIFFOUT_L1N/ADC1IN1), R23.P$2 (2)
unnamed: C20.P$1 (1), IC6.7 (DIFFIO_RX_L1P/DIFFOUT_L1P/ADC1IN2), R24.P$2 (2)
unnamed: C21.P$1 (1), IC6.8 (DIFFIO_RX_L3N/DIFFOUT_L3N/ADC1IN3), R25.P$2 (2)
unnamed: C22.P$1 (1), IC6.10 (DIFFIO_RX_L3P/DIFFOUT_L3P/ADC1IN4), R26.P$2 (2)
unnamed: C24.P$1 (1), IC6.12 (DIFFIO_RX_L5P/DIFFOUT_L5P/ADC1IN6), R28.P$1 (1)
unnamed: F4.2, IC6.9 (VCCIO1A)

Notes on the sheet:
FPGA - ADC INPUT

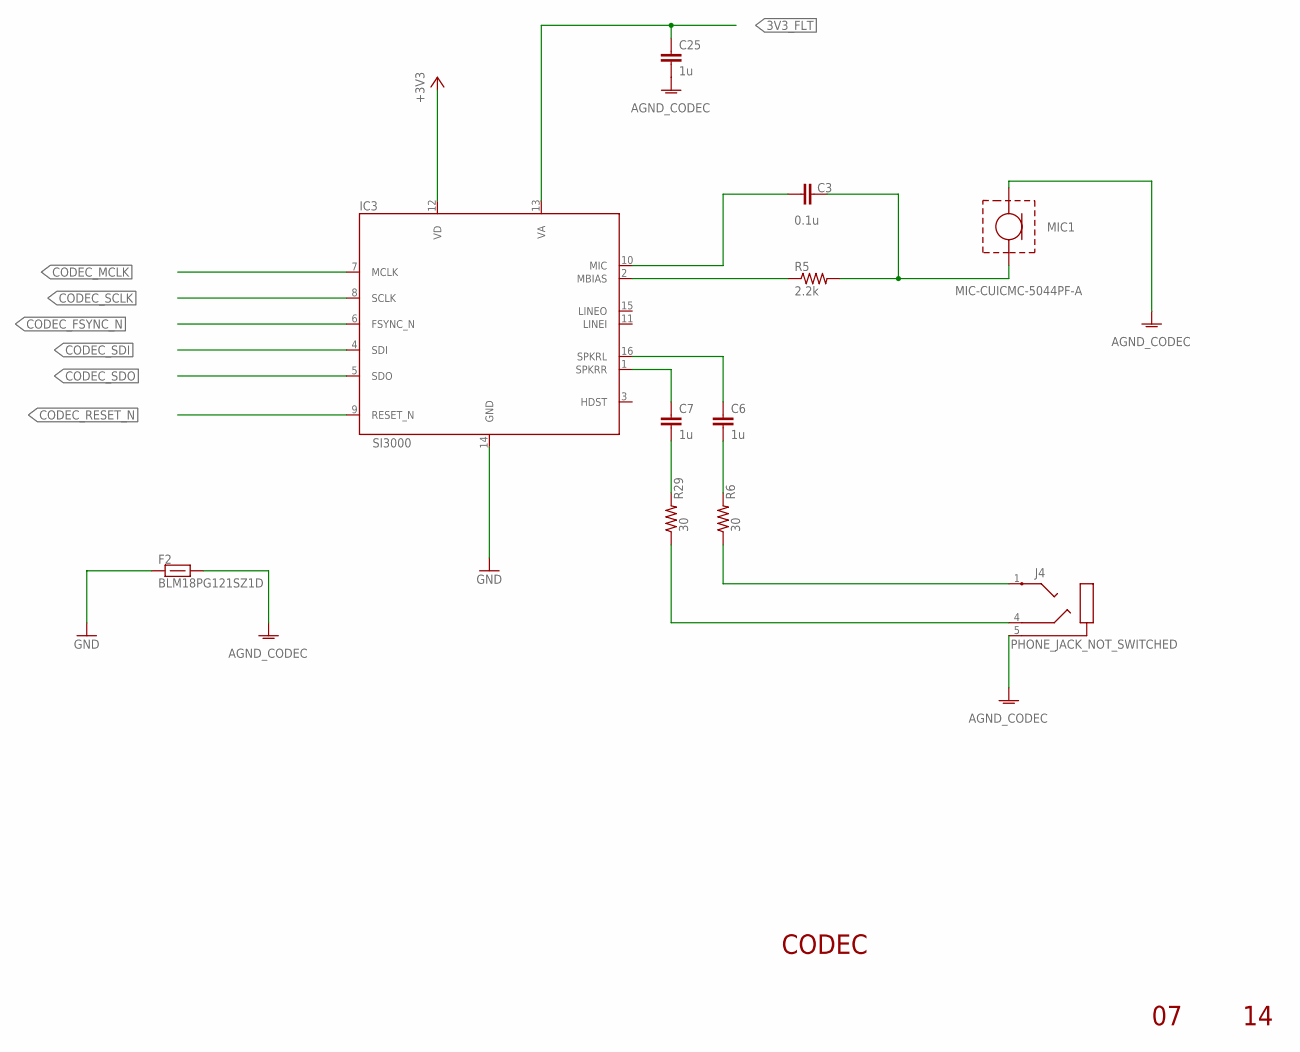
[picture p43: schematic PulseRain_M10.sch, sheet 7]

Parts:
C3: 0.1u; 0603-CAP
C6, C7, C25: 1u; VISHAY-R-0603
F2: BLM18PG121SZ1D; 0603-BEAD
IC3: SI3000; SOIC-16
J4: PHONE_JACK_NOT_SWITCHED
MIC1: MIC-CUICMC-5044PF-A; CMC-5044PF-A
R5: 2.2k; VISHAY-R-0603
R6, R29: 30; VISHAY-R-0603

Connections:
3V3_FLT: C25.P$1 (1), IC3.13 (VA); also elsewhere on the board
+3V3: IC3.12 (VD); also elsewhere on the board
AGND_CODEC: C25.P$2 (2), F2.2, J4.5, MIC1.1 (2)
CODEC_FSYNC_N: IC3.6 (FSYNC_N); also elsewhere on the board
CODEC_MCLK: IC3.7 (MCLK); also elsewhere on the board
CODEC_RESET_N: IC3.9 (RESET_N); also elsewhere on the board
CODEC_SCLK: IC3.8 (SCLK); also elsewhere on the board
CODEC_SDI: IC3.4 (SDI); also elsewhere on the board
CODEC_SDO: IC3.5 (SDO); also elsewhere on the board
GND: F2.1, IC3.14 (GND); also elsewhere on the board
unnamed: C3.1, IC3.10 (MIC)
unnamed: C6.P$1 (1), IC3.16 (SPKRL)
unnamed: C3.2, MIC1.2 (1), R5.P$2 (2)
unnamed: IC3.2 (MBIAS), R5.P$1 (1)
unnamed: C7.P$1 (1), IC3.1 (SPKRR)
unnamed: C7.P$2 (2), R29.P$2 (2)
unnamed: C6.P$2 (2), R6.P$2 (2)
unnamed: J4.1, R6.P$1 (1)
unnamed: J4.4, R29.P$1 (1)

Notes on the sheet:
CODEC

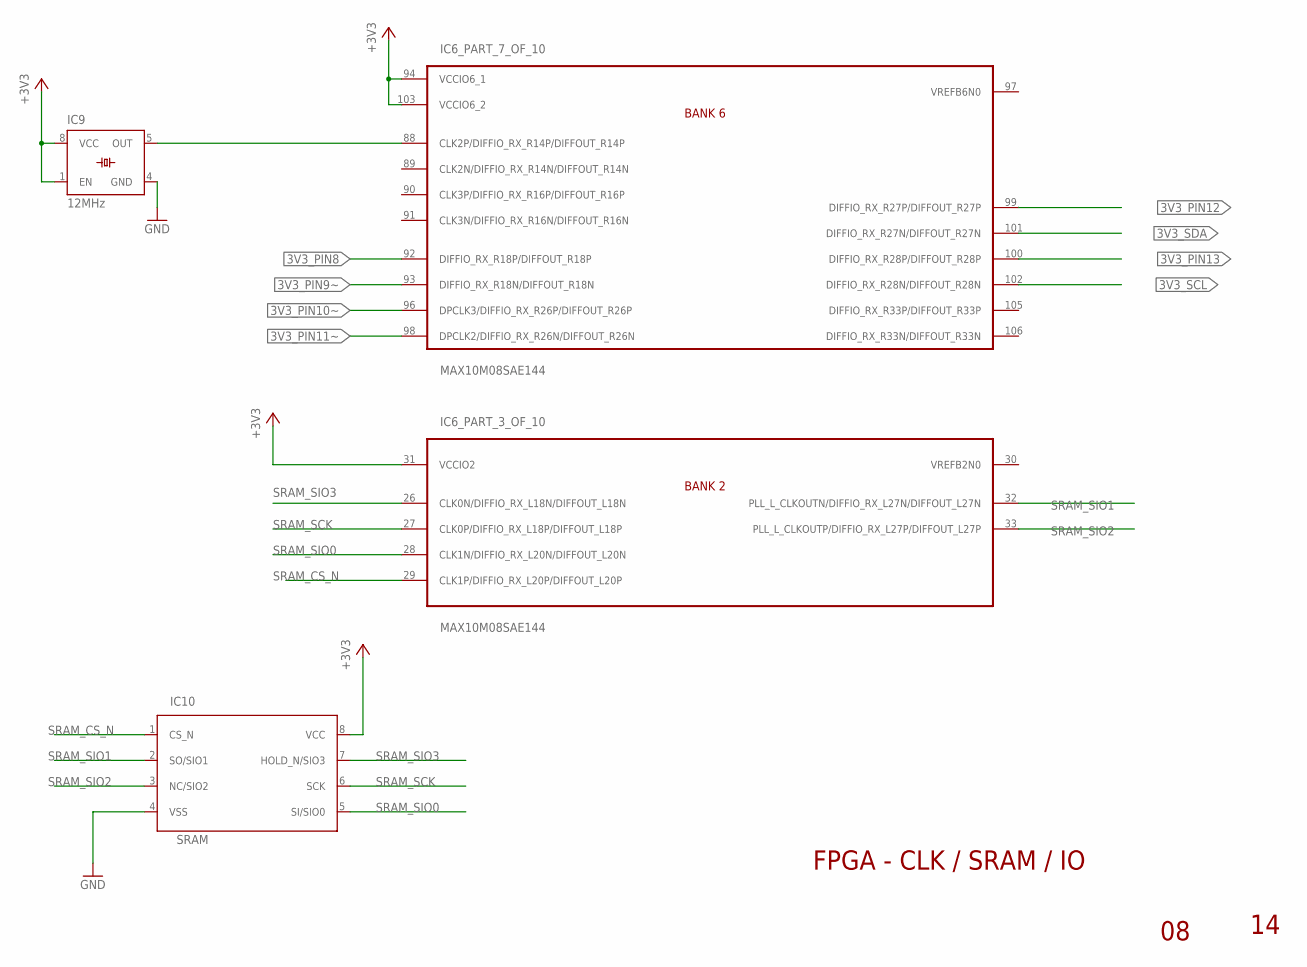
[picture p44: schematic PulseRain_M10.sch, sheet 8]

Parts:
IC6: MAX10M08SAE144; EQFP144
IC9: 12MHz; ACHL-DIP
IC10: SRAM; TSSOP-ST-8

Connections:
3V3_PIN8: IC6.92 (DIFFIO_RX_R18P/DIFFOUT_R18P); also elsewhere on the board
3V3_PIN9~: IC6.93 (DIFFIO_RX_R18N/DIFFOUT_R18N); also elsewhere on the board
3V3_PIN10~: IC6.96 (DPCLK3/DIFFIO_RX_R26P/DIFFOUT_R26P); also elsewhere on the board
3V3_PIN11~: IC6.98 (DPCLK2/DIFFIO_RX_R26N/DIFFOUT_R26N); also elsewhere on the board
3V3_PIN12: IC6.99 (DIFFIO_RX_R27P/DIFFOUT_R27P); also elsewhere on the board
3V3_PIN13: IC6.100 (DIFFIO_RX_R28P/DIFFOUT_R28P); also elsewhere on the board
3V3_SCL: IC6.102 (DIFFIO_RX_R28N/DIFFOUT_R28N); also elsewhere on the board
3V3_SDA: IC6.101 (DIFFIO_RX_R27N/DIFFOUT_R27N); also elsewhere on the board
+3V3: IC6.31 (VCCIO2), IC6.94 (VCCIO6_1), IC6.103 (VCCIO6_2), IC9.1 (EN), IC9.8 (VCC), IC10.8 (VCC); also elsewhere on the board
GND: IC9.4 (GND), IC10.4 (VSS); also elsewhere on the board
unnamed: IC6.88 (CLK2P/DIFFIO_RX_R14P/DIFFOUT_R14P), IC9.5 (OUT)
SRAM_CS_N: IC6.29 (CLK1P/DIFFIO_RX_L20P/DIFFOUT_L20P), IC10.1 (CS_N)
SRAM_SCK: IC6.27 (CLK0P/DIFFIO_RX_L18P/DIFFOUT_L18P), IC10.6 (SCK)
SRAM_SIO0: IC6.28 (CLK1N/DIFFIO_RX_L20N/DIFFOUT_L20N), IC10.5 (SI/SIO0)
SRAM_SIO1: IC6.32 (PLL_L_CLKOUTN/DIFFIO_RX_L27N/DIFFOUT_L2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), IC10.2 (SO/SIO1)
SRAM_SIO2: IC6.33 (PLL_L_CLKOUTP/DIFFIO_RX_L27P/DIFFOUT_L2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), IC10.3 (NC/SIO2)
SRAM_SIO3: IC6.26 (CLK0N/DIFFIO_RX_L18N/DIFFOUT_L18N), IC10.7 (HOLD_N/SIO3)

Notes on the sheet:
FPGA - CLK / SRAM / IO

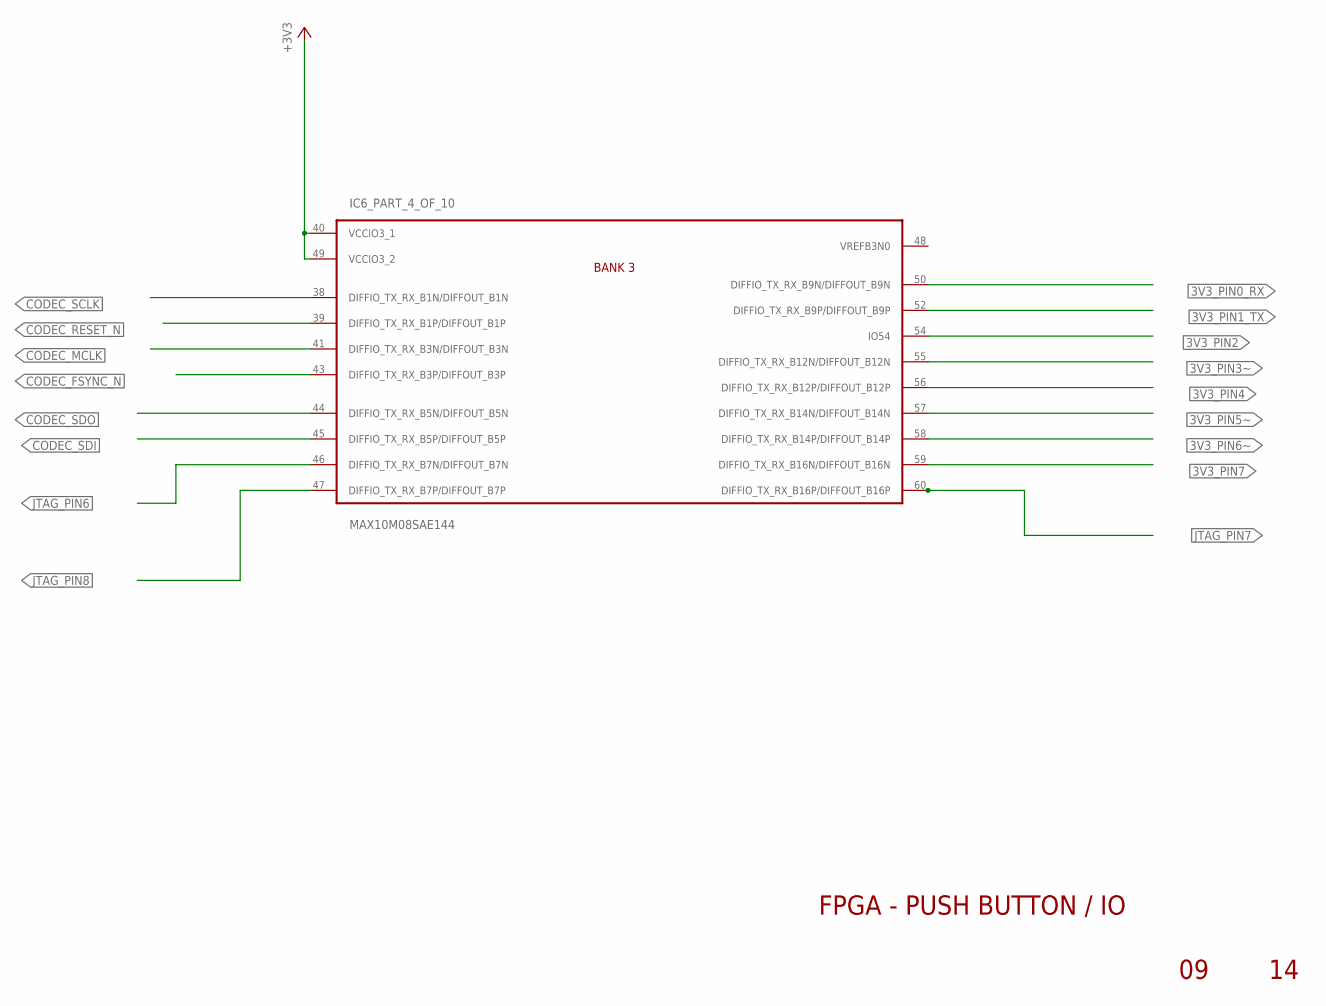
[picture p45: schematic PulseRain_M10.sch, sheet 9]

Parts:
IC6: MAX10M08SAE144; EQFP144

Connections:
3V3_PIN0_RX: IC6.50 (DIFFIO_TX_RX_B9N/DIFFOUT_B9N); also elsewhere on the board
3V3_PIN1_TX: IC6.52 (DIFFIO_TX_RX_B9P/DIFFOUT_B9P); also elsewhere on the board
3V3_PIN2: IC6.54 (IO54); also elsewhere on the board
3V3_PIN3~: IC6.55 (DIFFIO_TX_RX_B12N/DIFFOUT_B12N); also elsewhere on the board
3V3_PIN4: IC6.56 (DIFFIO_TX_RX_B12P/DIFFOUT_B12P); also elsewhere on the board
3V3_PIN5~: IC6.57 (DIFFIO_TX_RX_B14N/DIFFOUT_B14N); also elsewhere on the board
3V3_PIN6~: IC6.58 (DIFFIO_TX_RX_B14P/DIFFOUT_B14P); also elsewhere on the board
3V3_PIN7: IC6.59 (DIFFIO_TX_RX_B16N/DIFFOUT_B16N); also elsewhere on the board
+3V3: IC6.40 (VCCIO3_1), IC6.49 (VCCIO3_2); also elsewhere on the board
CODEC_FSYNC_N: IC6.43 (DIFFIO_TX_RX_B3P/DIFFOUT_B3P); also elsewhere on the board
CODEC_MCLK: IC6.41 (DIFFIO_TX_RX_B3N/DIFFOUT_B3N); also elsewhere on the board
CODEC_RESET_N: IC6.39 (DIFFIO_TX_RX_B1P/DIFFOUT_B1P); also elsewhere on the board
CODEC_SCLK: IC6.38 (DIFFIO_TX_RX_B1N/DIFFOUT_B1N); also elsewhere on the board
CODEC_SDI: IC6.45 (DIFFIO_TX_RX_B5P/DIFFOUT_B5P); also elsewhere on the board
CODEC_SDO: IC6.44 (DIFFIO_TX_RX_B5N/DIFFOUT_B5N); also elsewhere on the board
JTAG_PIN6: IC6.46 (DIFFIO_TX_RX_B7N/DIFFOUT_B7N); also elsewhere on the board
JTAG_PIN7: IC6.60 (DIFFIO_TX_RX_B16P/DIFFOUT_B16P); also elsewhere on the board
JTAG_PIN8: IC6.47 (DIFFIO_TX_RX_B7P/DIFFOUT_B7P); also elsewhere on the board

Notes on the sheet:
FPGA - PUSH BUTTON / IO

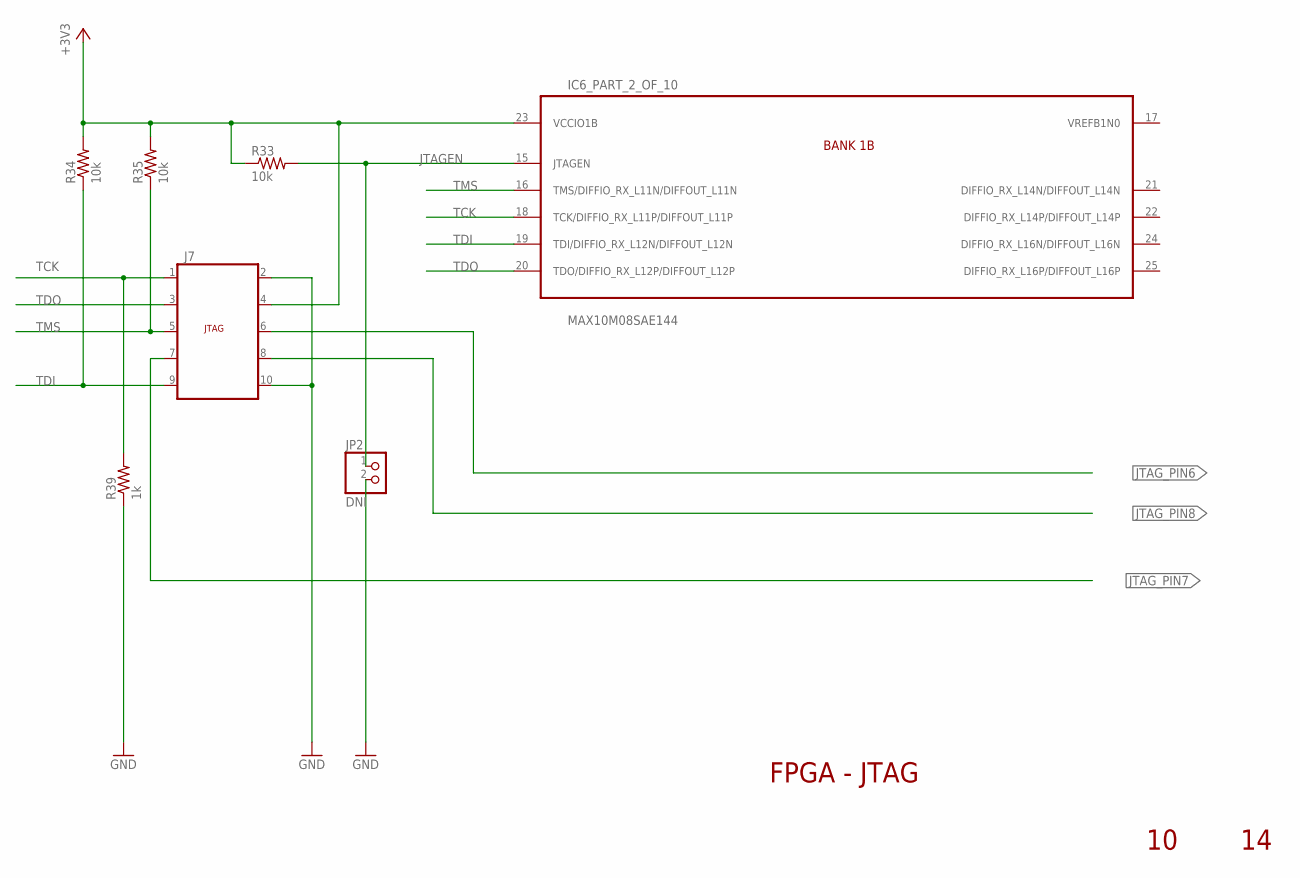
[picture p46: schematic PulseRain_M10.sch, sheet 10]

Parts:
IC6: MAX10M08SAE144; EQFP144
J7: ALTERA_JTAG; 2X05
JP2: DNI; 1X02
R33, R34, R35: 10k; VISHAY-R-0603
R39: 1k; VISHAY-R-0603

Connections:
+3V3: IC6.23 (VCCIO1B), J7.4, R33.P$1 (1), R34.P$2 (2), R35.P$2 (2); also elsewhere on the board
GND: J7.2, J7.10, JP2.2, R39.P$1 (1); also elsewhere on the board
JTAGEN: IC6.15 (JTAGEN), JP2.1, R33.P$2 (2)
JTAG_PIN6: J7.6; also elsewhere on the board
JTAG_PIN7: J7.7; also elsewhere on the board
JTAG_PIN8: J7.8; also elsewhere on the board
TCK: IC6.18 (TCK/DIFFIO_RX_L11P/DIFFOUT_L11P), J7.1, R39.P$2 (2)
TDI: IC6.19 (TDI/DIFFIO_RX_L12N/DIFFOUT_L12N), J7.9, R34.P$1 (1)
TDO: IC6.20 (TDO/DIFFIO_RX_L12P/DIFFOUT_L12P), J7.3
TMS: IC6.16 (TMS/DIFFIO_RX_L11N/DIFFOUT_L11N), J7.5, R35.P$1 (1)

Notes on the sheet:
FPGA - JTAG

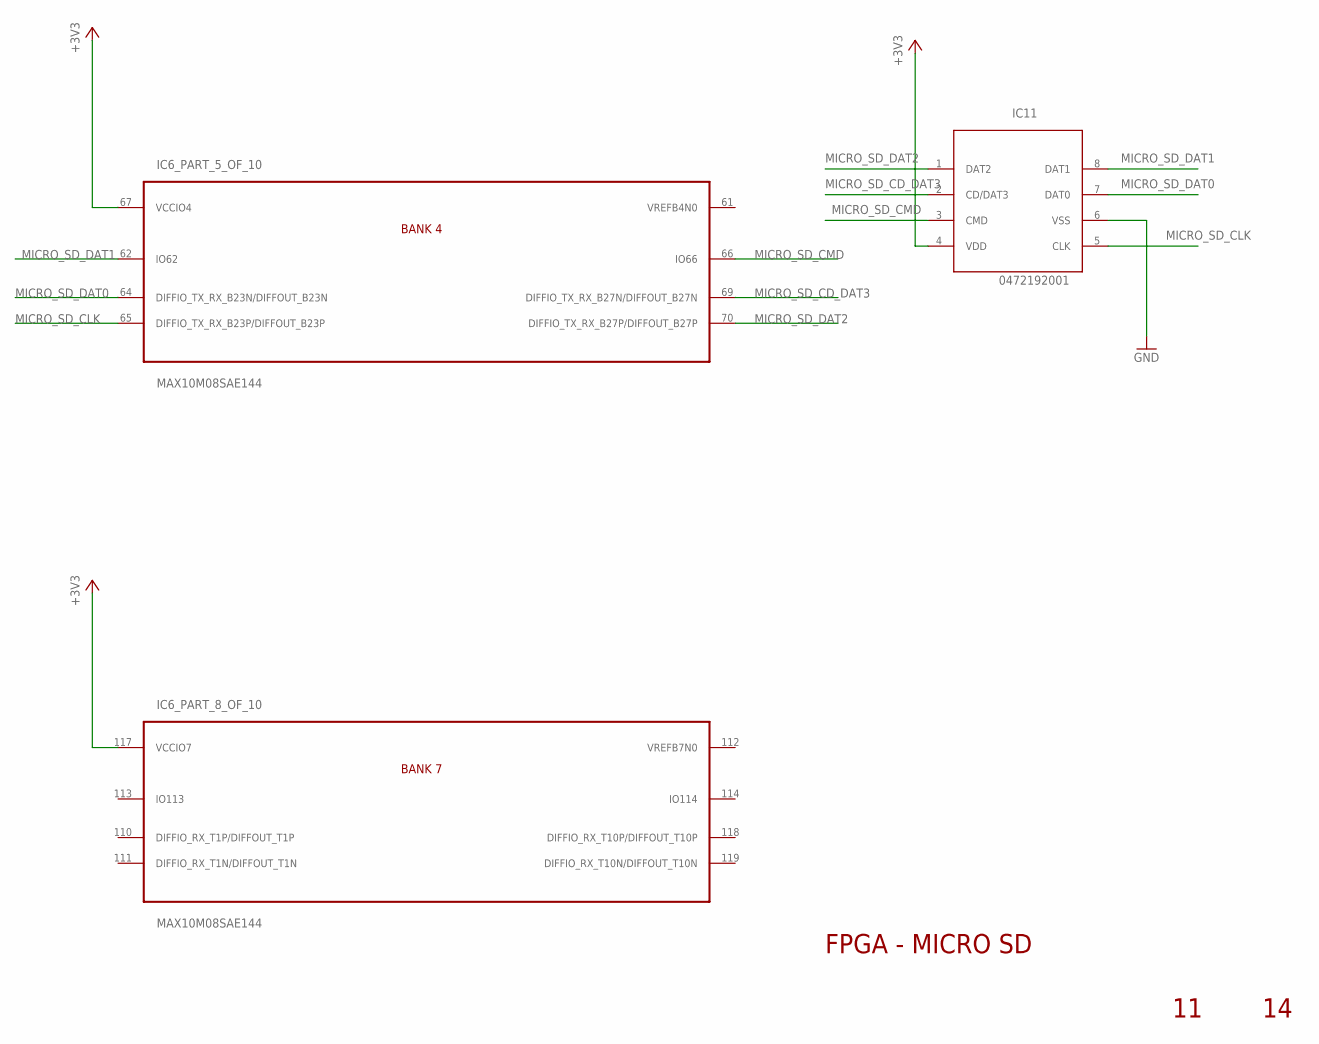
[picture p47: schematic PulseRain_M10.sch, sheet 11]

Parts:
IC6: MAX10M08SAE144; EQFP144
IC11: 0472192001; MOLEX-0472192001

Connections:
+3V3: IC6.67 (VCCIO4), IC6.117 (VCCIO7), IC11.4 (VDD); also elsewhere on the board
GND: IC11.6 (VSS); also elsewhere on the board
MICRO_SD_CD_DAT3: IC6.69 (DIFFIO_TX_RX_B27N/DIFFOUT_B27N), IC11.2 (CD/DAT3)
MICRO_SD_CLK: IC6.65 (DIFFIO_TX_RX_B23P/DIFFOUT_B23P), IC11.5 (CLK)
MICRO_SD_CMD: IC6.66 (IO66), IC11.3 (CMD)
MICRO_SD_DAT0: IC6.64 (DIFFIO_TX_RX_B23N/DIFFOUT_B23N), IC11.7 (DAT0)
MICRO_SD_DAT1: IC6.62 (IO62), IC11.8 (DAT1)
MICRO_SD_DAT2: IC6.70 (DIFFIO_TX_RX_B27P/DIFFOUT_B27P), IC11.1 (DAT2)

Notes on the sheet:
FPGA - MICRO SD

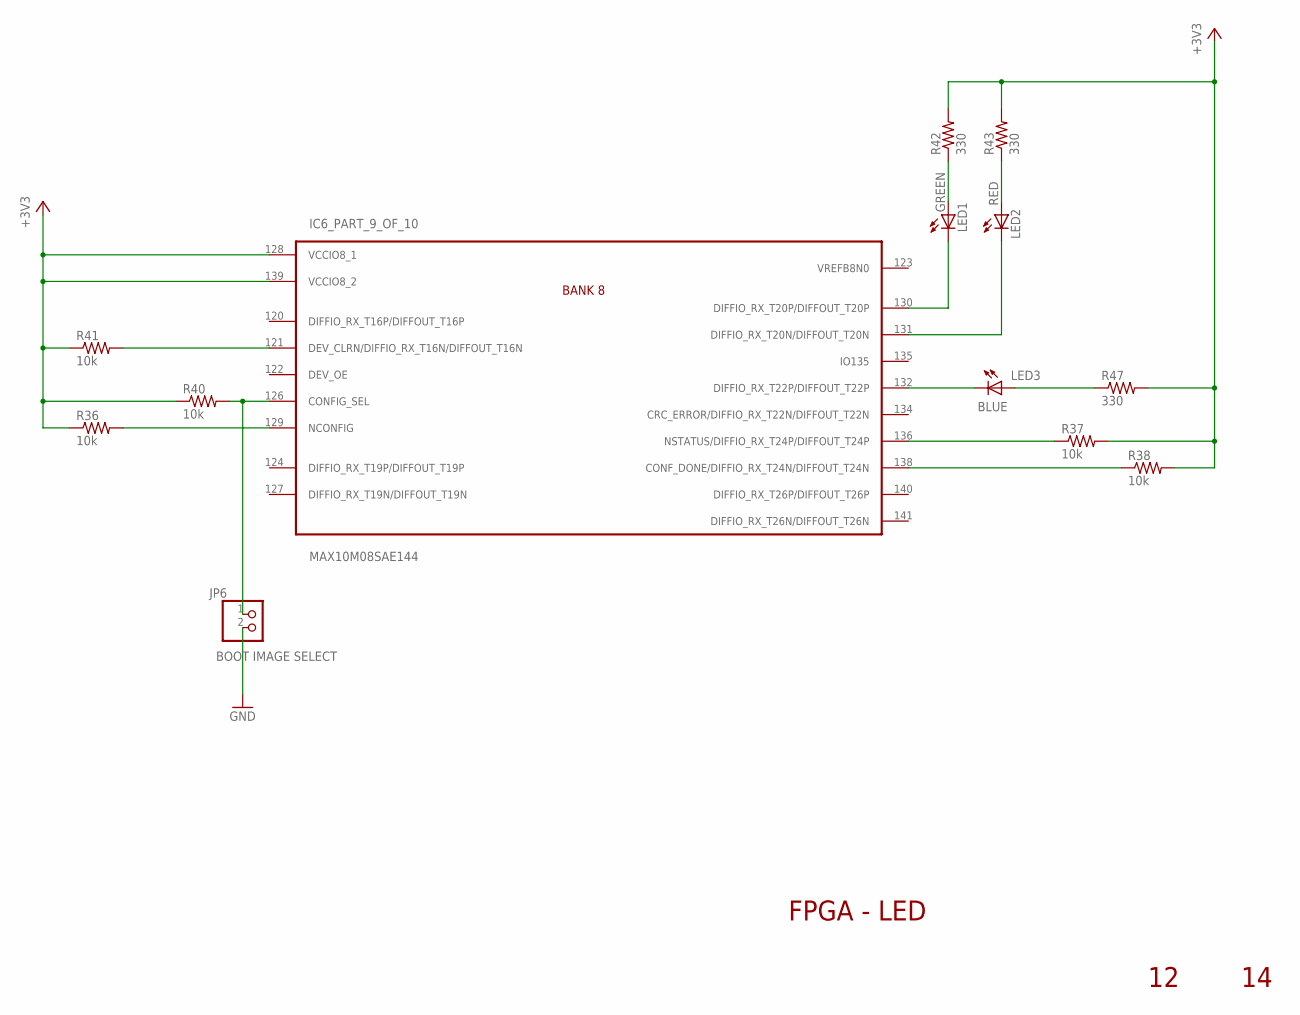
[picture p48: schematic PulseRain_M10.sch, sheet 12]

Parts:
IC6: MAX10M08SAE144; EQFP144
JP6: BOOT IMAGE SELECT; 1X02
LED1: GREEN; HARVATEK_0603
LED2: RED; HARVATEK_0603
LED3: BLUE; HARVATEK_0603
R36, R37, R38, R40, R41: 10k; VISHAY-R-0603
R42, R43, R47: 330; VISHAY-R-0603

Connections:
+3V3: IC6.128 (VCCIO8_1), IC6.139 (VCCIO8_2), R36.P$1 (1), R37.P$2 (2), R38.P$2 (2), R40.P$1 (1), R41.P$1 (1), R42.P$2 (2), R43.P$2 (2), R47.P$2 (2); also elsewhere on the board
GND: JP6.2; also elsewhere on the board
unnamed: IC6.132 (DIFFIO_RX_T22P/DIFFOUT_T22P), LED3.C
unnamed: IC6.129 (NCONFIG), R36.P$2 (2)
unnamed: IC6.136 (NSTATUS/DIFFIO_RX_T24P/DIFFOUT_T24P), R37.P$1 (1)
unnamed: IC6.138 (CONF_DONE/DIFFIO_RX_T24N/DIFFOUT_T24N), R38.P$1 (1)
unnamed: IC6.126 (CONFIG_SEL), JP6.1, R40.P$2 (2)
unnamed: IC6.121 (DEV_CLRN/DIFFIO_RX_T16N/DIFFOUT_T16N), R41.P$2 (2)
unnamed: IC6.130 (DIFFIO_RX_T20P/DIFFOUT_T20P), LED1.C
unnamed: IC6.131 (DIFFIO_RX_T20N/DIFFOUT_T20N), LED2.C
unnamed: LED1.A, R42.P$1 (1)
unnamed: LED2.A, R43.P$1 (1)
unnamed: LED3.A, R47.P$1 (1)

Notes on the sheet:
FPGA - LED
