PulseRain/M10_PCB/V1.11/PulseRain_M10.brd

## EAGLE design V1.11/PulseRain_M10.brd (continued)

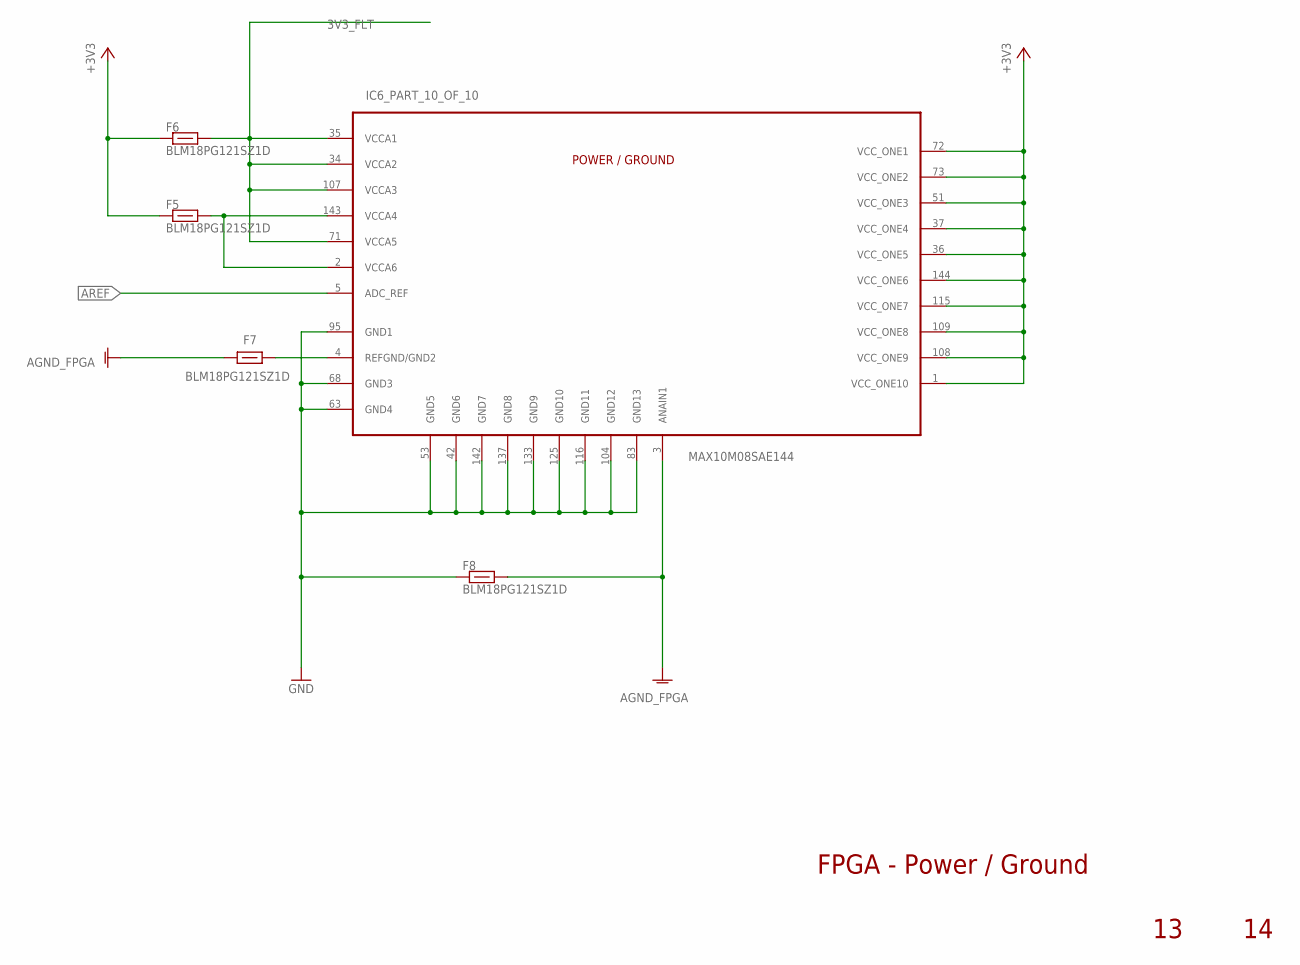
[picture p49: schematic PulseRain_M10.sch, sheet 13]

Parts:
F5, F6, F7, F8: BLM18PG121SZ1D; 0603-BEAD
IC6: MAX10M08SAE144; EQFP144

Connections:
3V3_FLT: F6.2, IC6.34 (VCCA2), IC6.35 (VCCA1), IC6.71 (VCCA5), IC6.107 (VCCA3); also elsewhere on the board
+3V3: F5.1, F6.1, IC6.1 (VCC_ONE10), IC6.36 (VCC_ONE5), IC6.37 (VCC_ONE4), IC6.51 (VCC_ONE3), IC6.72 (VCC_ONE1), IC6.73 (VCC_ONE2), IC6.108 (VCC_ONE9), IC6.109 (VCC_ONE8), IC6.115 (VCC_ONE7), IC6.144 (VCC_ONE6); also elsewhere on the board
AGND_FPGA: F7.1, F8.2, IC6.3 (ANAIN1); also elsewhere on the board
AREF: IC6.5 (ADC_REF); also elsewhere on the board
GND: F8.1, IC6.42 (GND6), IC6.53 (GND5), IC6.63 (GND4), IC6.68 (GND3), IC6.83 (GND13), IC6.95 (GND1), IC6.104 (GND12), IC6.116 (GND11), IC6.125 (GND10), IC6.133 (GND9), IC6.137 (GND8), IC6.142 (GND7); also elsewhere on the board
unnamed: F5.2, IC6.2 (VCCA6), IC6.143 (VCCA4)
unnamed: F7.2, IC6.4 (REFGND/GND2)

Notes on the sheet:
FPGA - Power / Ground

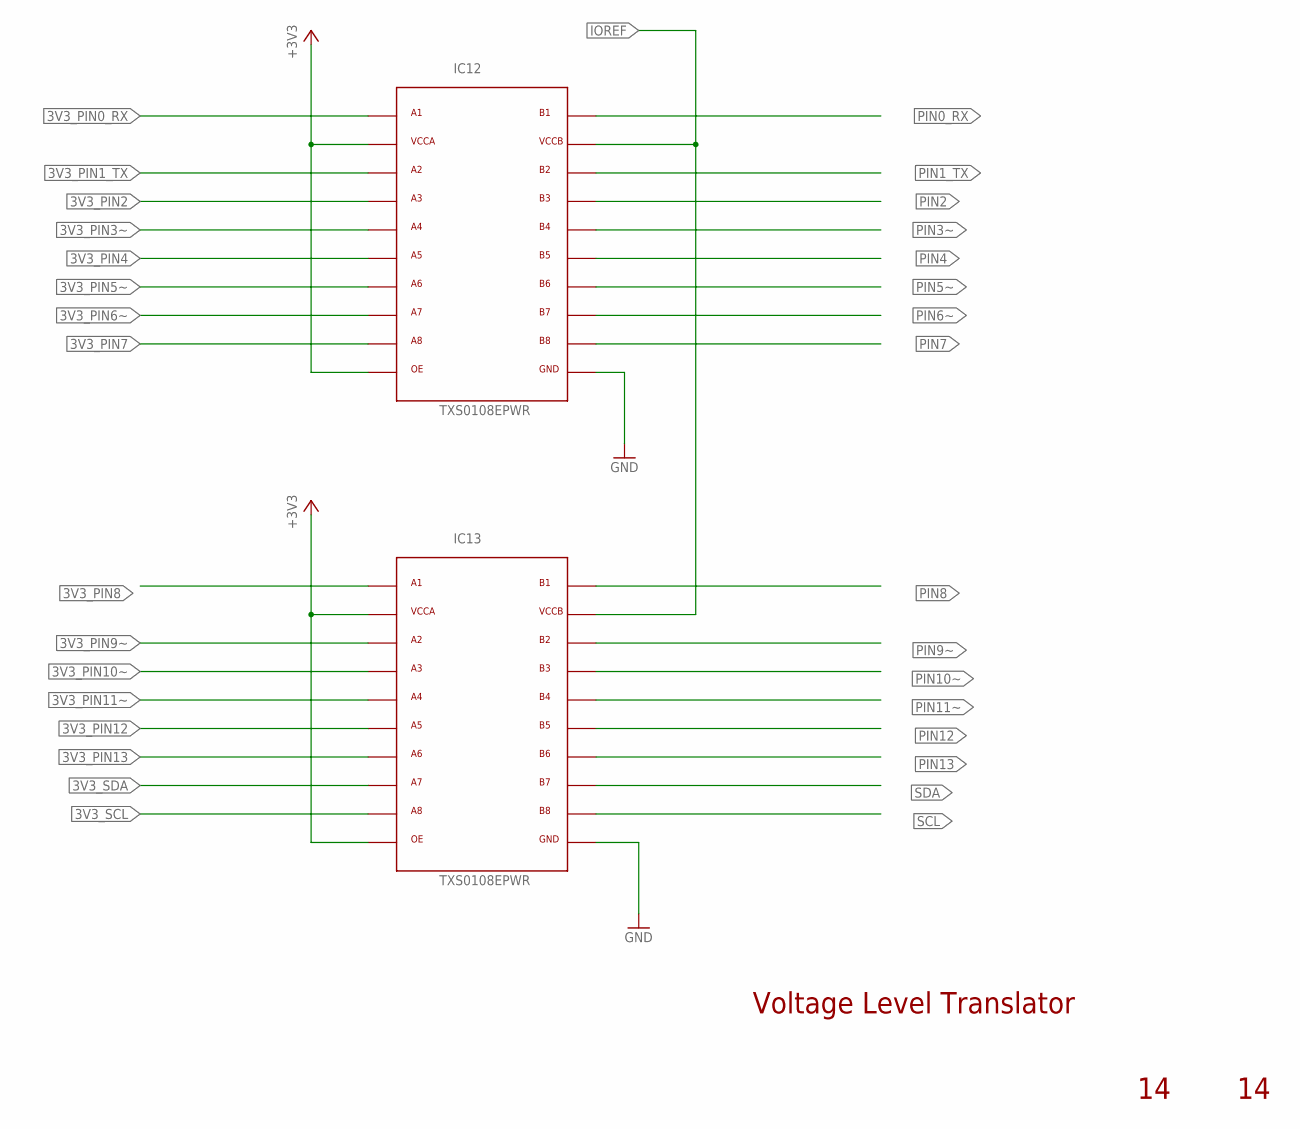
[picture p50: schematic PulseRain_M10.sch, sheet 14]

Parts:
IC12, IC13: TXS0108EPWR; TSSOP8

Connections:
3V3_PIN0_RX: IC12.1; also elsewhere on the board
3V3_PIN1_TX: IC12.3; also elsewhere on the board
3V3_PIN2: IC12.4; also elsewhere on the board
3V3_PIN3~: IC12.5; also elsewhere on the board
3V3_PIN4: IC12.6; also elsewhere on the board
3V3_PIN5~: IC12.7; also elsewhere on the board
3V3_PIN6~: IC12.8; also elsewhere on the board
3V3_PIN7: IC12.9; also elsewhere on the board
3V3_PIN8: IC13.1; also elsewhere on the board
3V3_PIN9~: IC13.3; also elsewhere on the board
3V3_PIN10~: IC13.4; also elsewhere on the board
3V3_PIN11~: IC13.5; also elsewhere on the board
3V3_PIN12: IC13.6; also elsewhere on the board
3V3_PIN13: IC13.7; also elsewhere on the board
3V3_SCL: IC13.9; also elsewhere on the board
3V3_SDA: IC13.8; also elsewhere on the board
+3V3: IC12.2, IC12.10, IC13.2, IC13.10; also elsewhere on the board
GND: IC12.11, IC13.11; also elsewhere on the board
IOREF: IC12.19, IC13.19; also elsewhere on the board
PIN0_RX: IC12.20; also elsewhere on the board
PIN1_TX: IC12.18; also elsewhere on the board
PIN2: IC12.17; also elsewhere on the board
PIN3~: IC12.16; also elsewhere on the board
PIN4: IC12.15; also elsewhere on the board
PIN5~: IC12.14; also elsewhere on the board
PIN6~: IC12.13; also elsewhere on the board
PIN7: IC12.12; also elsewhere on the board
PIN8: IC13.20; also elsewhere on the board
PIN9~: IC13.18; also elsewhere on the board
PIN10~: IC13.17; also elsewhere on the board
PIN11~: IC13.16; also elsewhere on the board
PIN12: IC13.15; also elsewhere on the board
PIN13: IC13.14; also elsewhere on the board
SCL: IC13.12; also elsewhere on the board
SDA: IC13.13; also elsewhere on the board

Notes on the sheet:
Voltage Level Translator

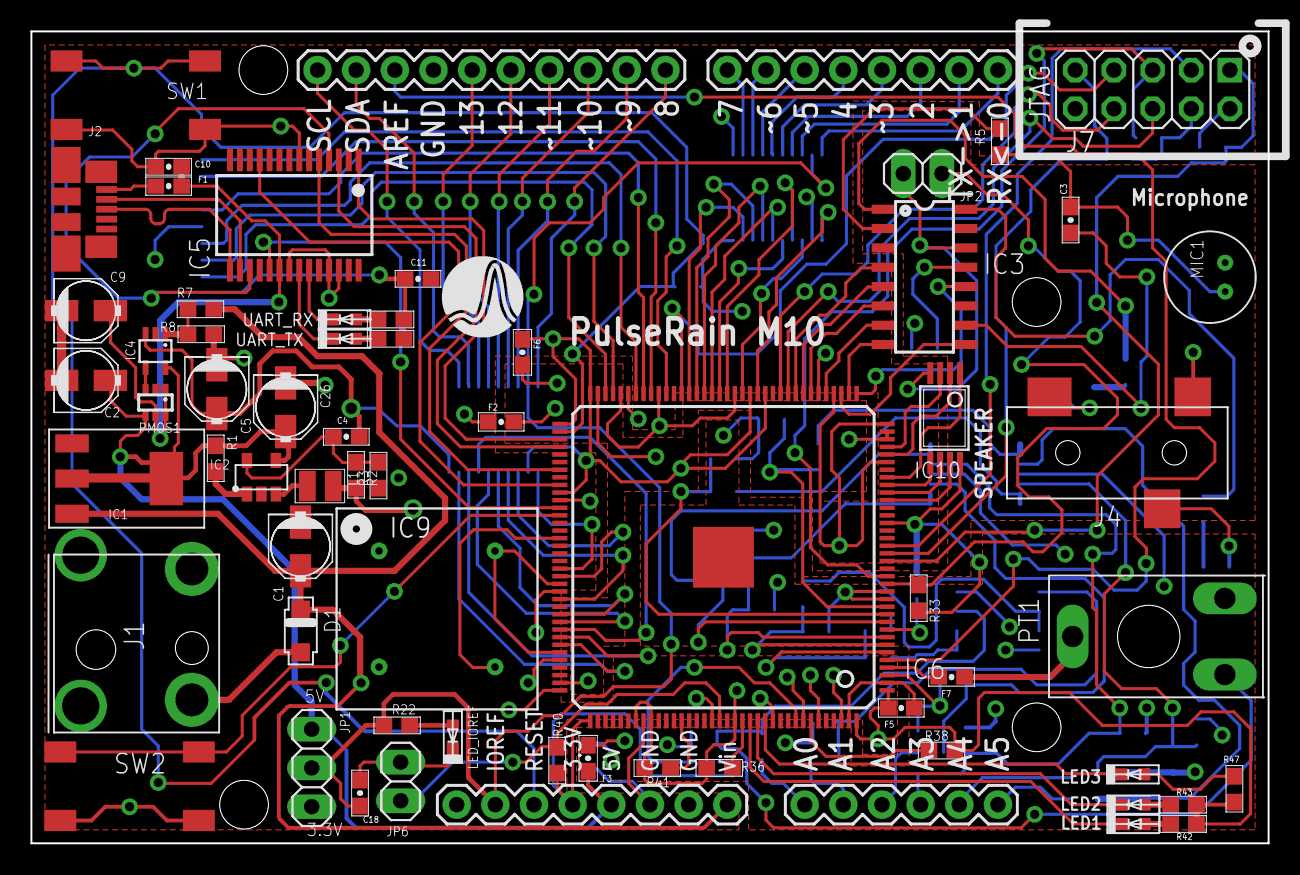
[picture p51: board PulseRain_M10.brd from above]

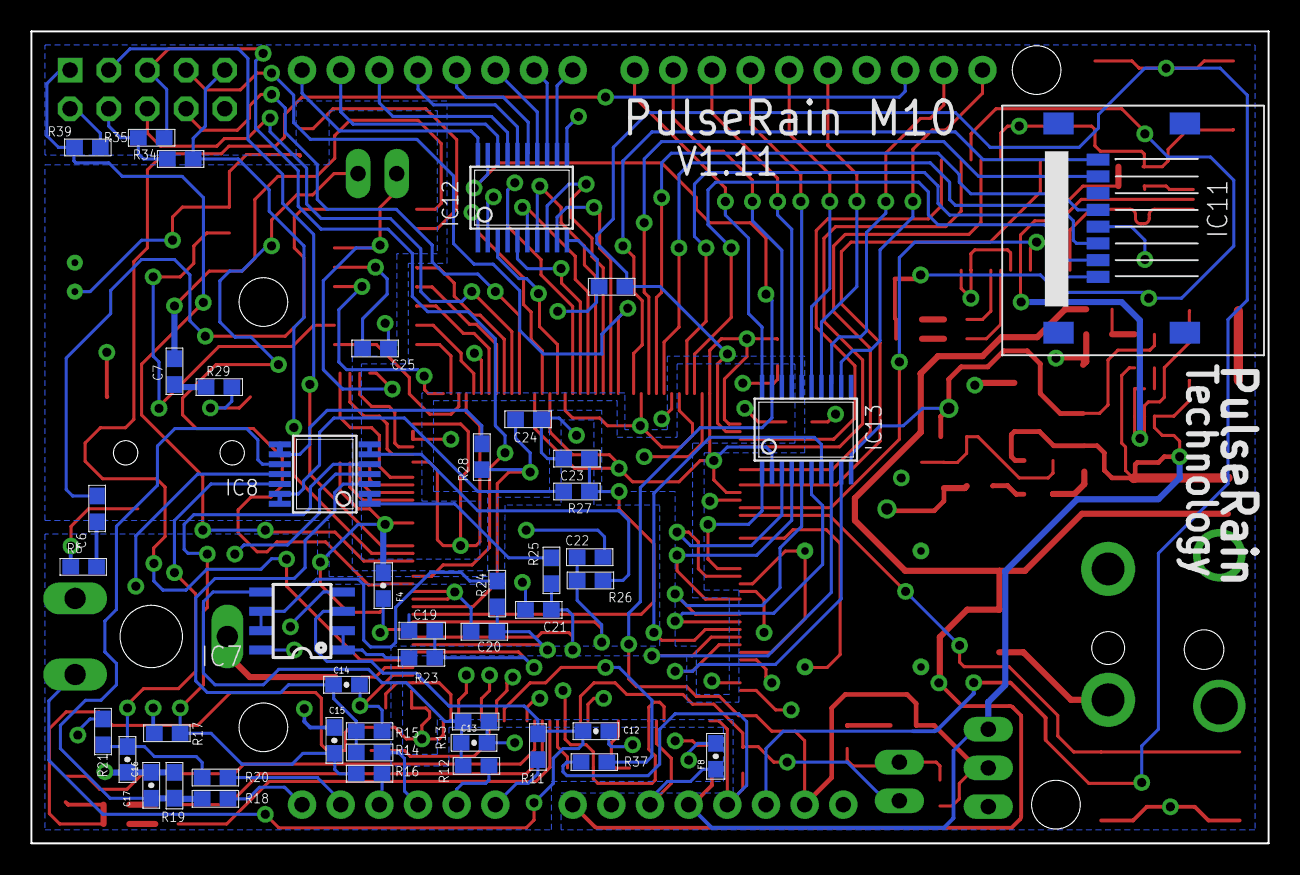
[picture p52: board PulseRain_M10.brd from below]

Board: 4 copper layers, 81.3 x 53.3 mm, 113 parts (46 on the bottom side), 139 nets.
