PulseRain/M10_PCB/(commit log)

2017-02-23 add V0.9 (code name Mustang Duino)
    [Mustang_Duino.brd, Mustang_Duino.sch]
2017-04-23 add V1.0, pilot run for production
    [PulseRain_M10.brd, PulseRain_M10.sch]
2017-11-02 add V1.11 schematic and layout
    [PulseRain_M10.brd, PulseRain_M10.sch]
2017-11-20 add pdf schematic for V1.0
